harukakido/NASAProject.FPGACompatibleMIPICameraInterfaceAdapterBoard/Images of Final Adapter Board/Final Adapter Board 2D JPG.JPG

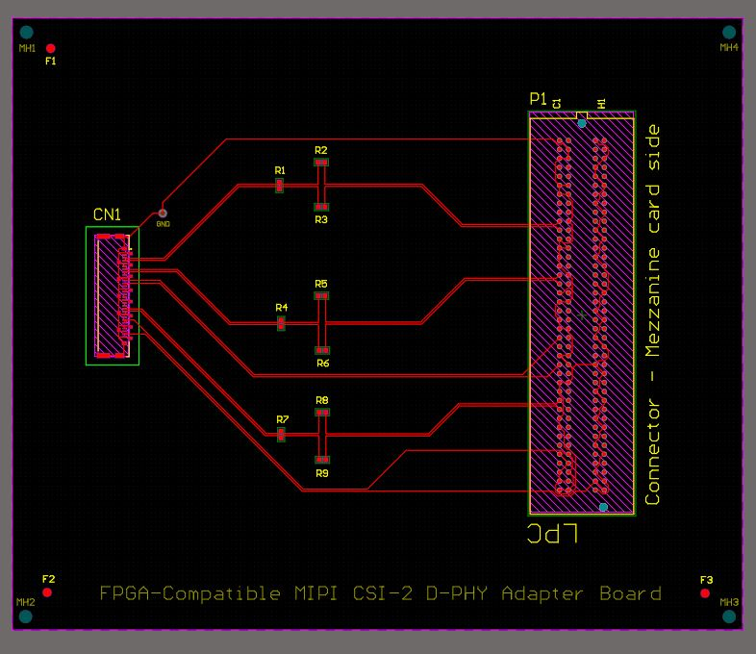
Images of Final Adapter Board/Final Adapter Board 2D JPG.JPG
