harukakido/NASAProject.FPGACompatibleMIPICameraInterfaceAdapterBoard/Images of Final Adapter Board/Final Adapter Board 3D Top JPG.JPG

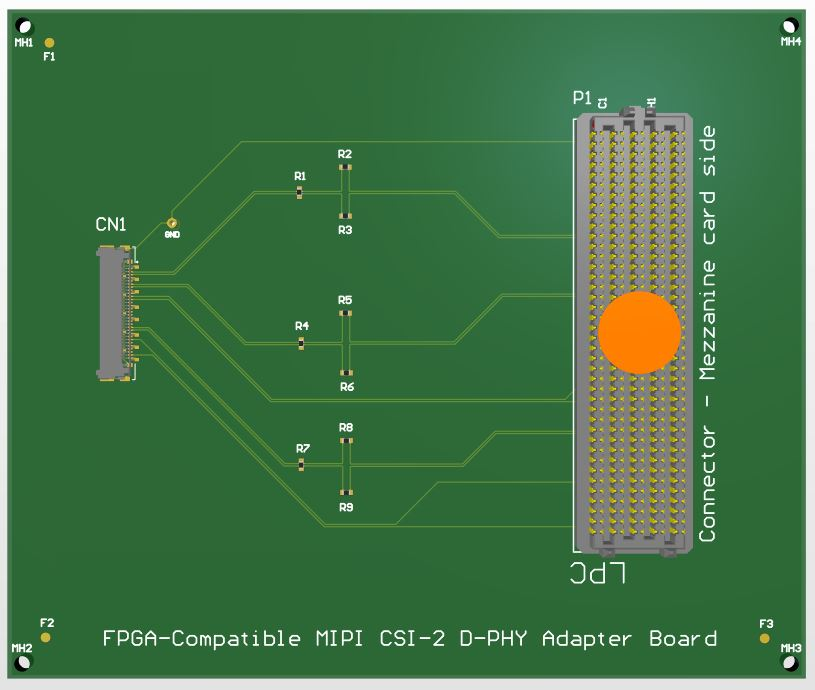
Images of Final Adapter Board/Final Adapter Board 3D Top JPG.JPG
