harukakido/NASAProject.FPGACompatibleMIPICameraInterfaceAdapterBoard/Altium PCB Output List.txt

Altium PCB Output List:

1. Fabrication Outputs: Gerbers, NC Drill Files

2. Export Outputs:
3D STEP File (View after upload to online AutoDesk Viewer)

3. Assembly Drawing (PCB Print as PDF)

4. Assembly Outputs:
Pick and Place

5. Documentation Outputs:
PDF Schematic, 3D PDF, Draftsman

6. Report Outputs:
Bill of Materials (BOM)
	
*Printing at Home: Composite Drawing (for Layers)
