harukakido/NASAProject.FPGACompatibleMIPICameraInterfaceAdapterBoard/Altium PCB Output List.docx

Altium PCB Output List:

1. Fabrication Outputs:
- Gerbers (test file output via ViewMate in PentaLogix)
- NC Drill Files
- ODB

2. Export Outputs:

- 3D STEP File (View after upload to online AutoDesk Viewer)
3. Assembly Drawing (PCB Print as PDF)
4. Assembly Outputs: Pick and Place

5. Documentation Outputs:

- PDF Schematic, 3D PDF, Draftsman (Top Side)
- *Printing at Home: Composite Drawing (Layers)
5. Report Outputs:
  - Bill of Materials (BOM)
