harukakido/NASAProject.FPGACompatibleMIPICameraInterfaceAdapterBoard/Deliverables/Final Presentation. Embedded Processing.pdf

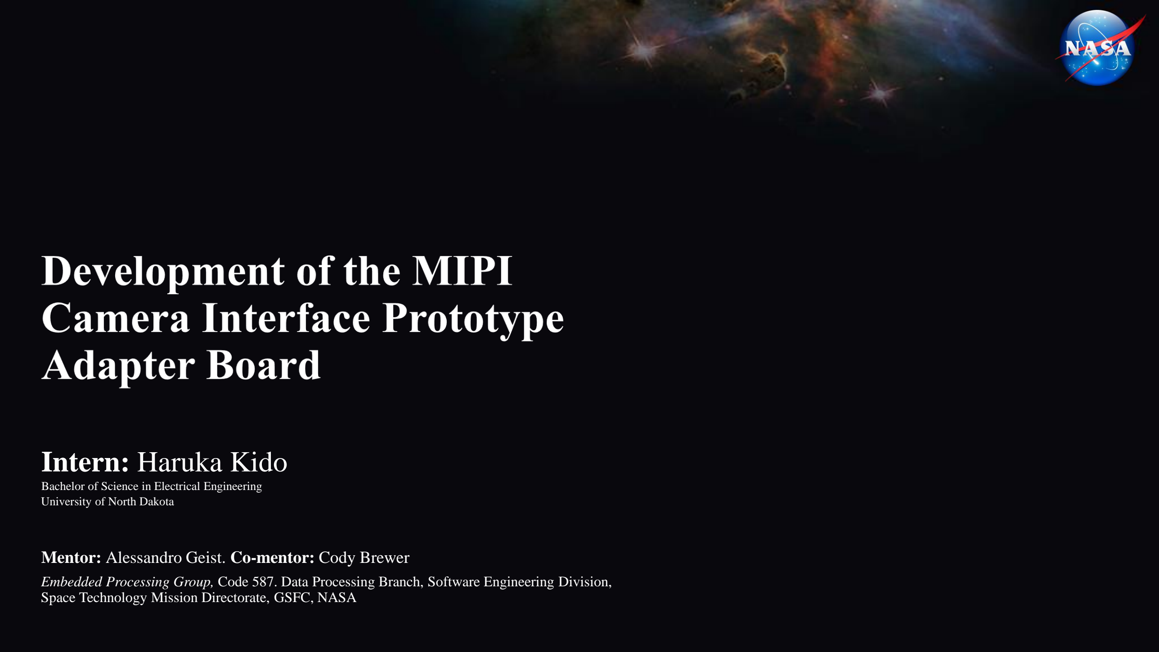
[picture p3: page 1]

# Intern: Haruka Kido

Embedded Processing Group, Code 587. Data Processing Branch, Software Engineering Division,

### Space Technology Mission Directorate, GSFC, NASA

## Mentor: Alessandro Geist. Co-mentor: Cody Brewer

Bachelor of Science in Electrical Engineering University of North Dakota

This project is the development of the prototype FPGA-Compatible MIPI CSI-2 (Camera Serial Interface) D-PHY adapter board. The FPGA used on the SpaceCube processor card does not have I/O that natively supports the D-PHY standard, and thus requires additional external components to adapt the interface to the FPGAs I/O. The goal of this project is to develop a prototype board with this external circuitry. The project tasks include 1) preliminary research and analysis of the adapter circuit requirements involving waveform comparisons, 2) signal processing chain tests for voltage measurements, 3) calculations from I/O channel system simulations in TI-TINA, 4) components’ values and circuit configuration verifications, 5) protoboard schematic entry, 6) both PCB footprint builds and PCB layout in Altium Designer, and lastly, 7) PCB manufacturing. This adapter board is useful in data conversion and transmission from the MIPI camera module to the FPGA, a D-PHY circuit arrangement used in NASA’s SpaceCube Mini’s VADIR (Versatile Analog/Digital Interface) between the MIPI Camera module and the Backplane Connector.

## FPGA-Compatible MIPI CSI-2 D-PHY Adapter Board Development Methodology

## Protoboard Fabrication

## Protoboard PCB Layout

•PCB footprint builds
> Component
placements
•Determination of PCB
Stack-Up and Rules
(length-matching for
differential pairs,
controlled impedance,
copper specifications:
trace measurements)
> Trace Routing

## Protoboard Schematic Entry (Altium)

•Parts selection and
symbol builds
•Schematic Entry: Add
and wire components,
adjust I/O pin
arrangements

## Conversion Simulation of MIPI (TI TINA)

•Research MIPI D-PHY and LVDS:
Expected Voltage
Levels and Rates
•Transmitter and
Receiver Circuit
Simulations
•Waveform Outputs
from signal
processing chain
tests for voltage
measurements
•Calculations from
I/O channel system
simulations
•Components’ values
and circuit
configuration
verifications

•Final gerber file
output, assembly
drawings, BOM
•Quotes
•Place Order
NASA Embedded Processing Internship, Summer 2021 | 2

# Engineering Contextualization: SpaceCube Configurable Slices

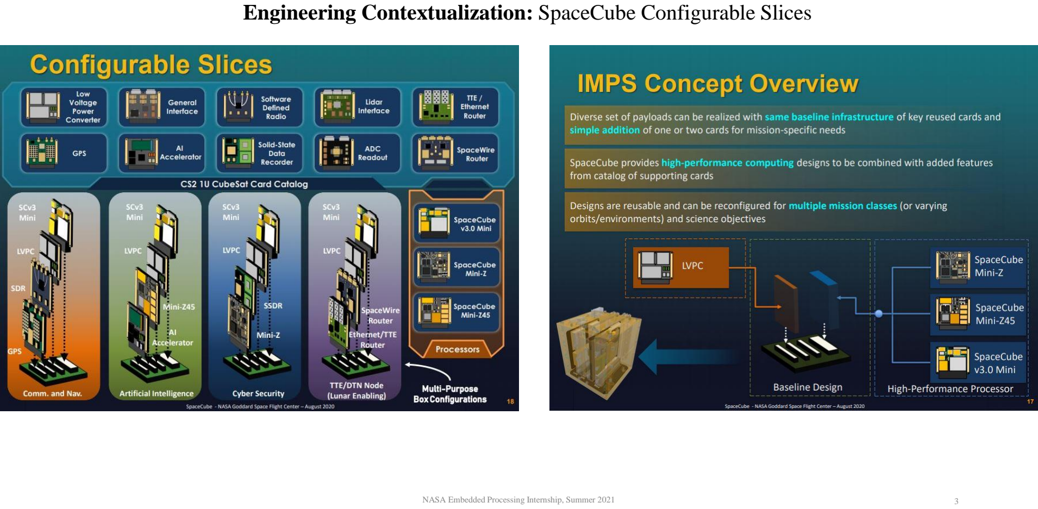
[picture p4: page 3]

# Engineering Contextualization: MIPI Adapter in SpaceCube’s Versatile Analog-Digital Interface (VADIR) Card

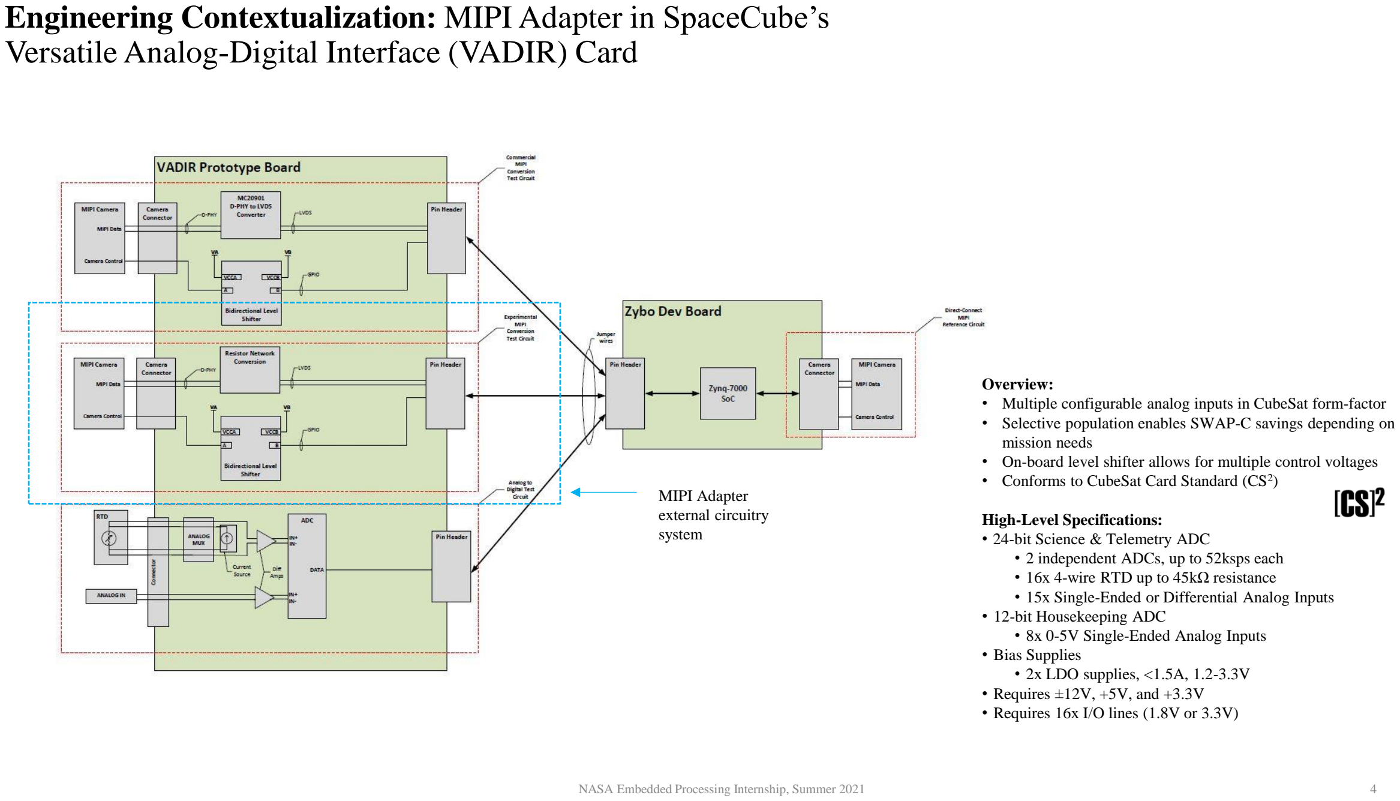
[picture p5: page 4]

MIPI Adapter
external circuitry
system

Overview:
- Multiple configurable analog inputs in CubeSat form-factor
- Selective population enables SWAP-C savings depending on mission needs
- On-board level shifter allows for multiple control voltages
- Conforms to CubeSat Card Standard (CS²
)

High-Level Specifications:
- 24-bit Science & Telemetry ADC
- 2 independent ADCs, up to 52ksps each
- 16x 4-wire RTD up to 45kΩ resistance
- 15x Single-Ended or Differential Analog Inputs
- 12-bit Housekeeping ADC
- 8x 0-5V Single-Ended Analog Inputs
- Bias Supplies
- 2x LDO supplies, <1.5A, 1.2-3.3V
- Requires ±12V, +5V, and +3.3V
- Requires 16x I/O lines (1.8V or 3.3V)

## Preliminary Research and Analysis: Schematics of Resistor Networks

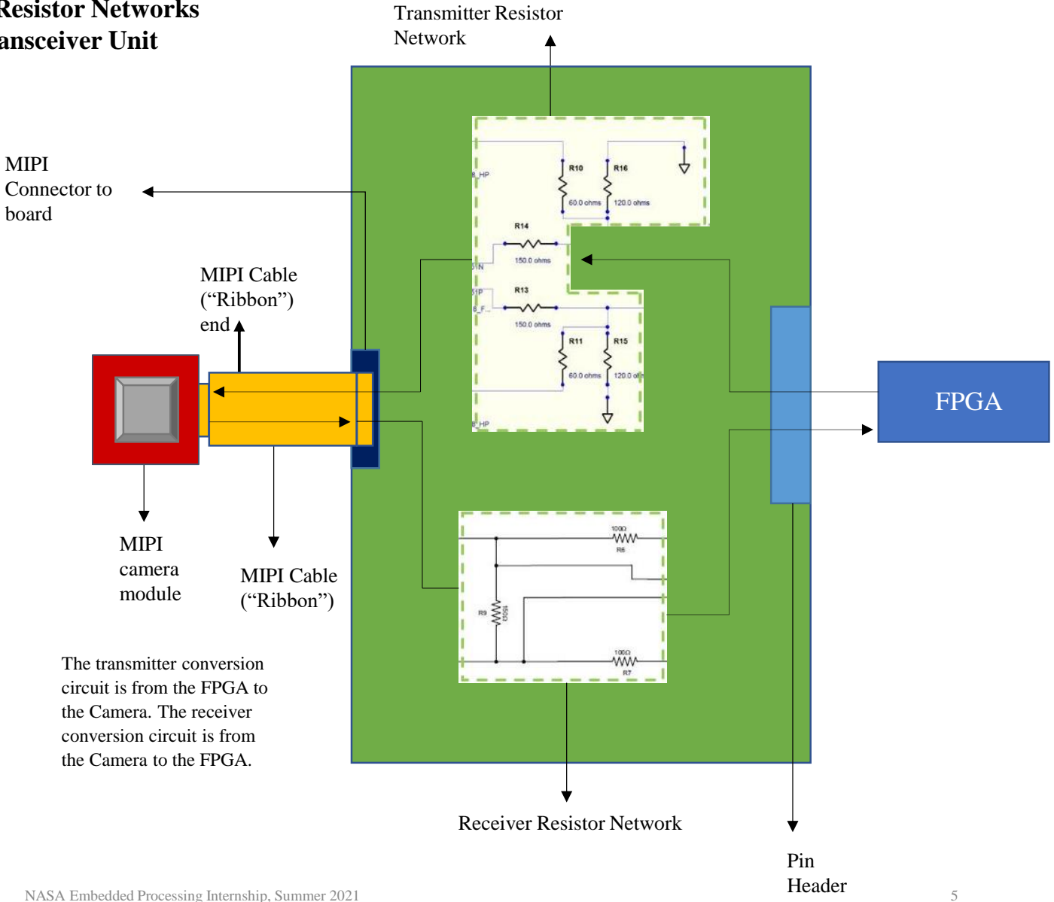
[picture p6: figure]
Pin Header; MIPI Cable (“Ribbon”); Transmitter Resistor Network; MIPI Connector to board; MIPI Cable (“Ribbon”) end; MIPI camera module; FPGA; Receiver Resistor Network; The transmitter conversion circuit is from the FPGA to the Camera. The receiver conversion circuit is from the Camera to the FPGA.

## and System Integration Mapping of MIPI CSI-2 Transceiver Unit

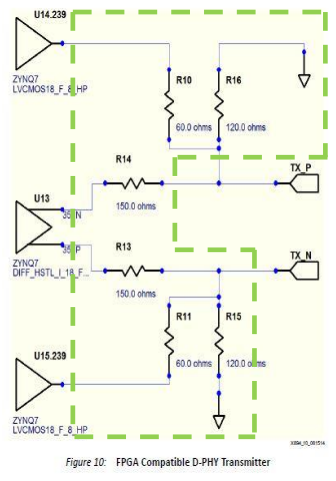
[picture p7: figure]
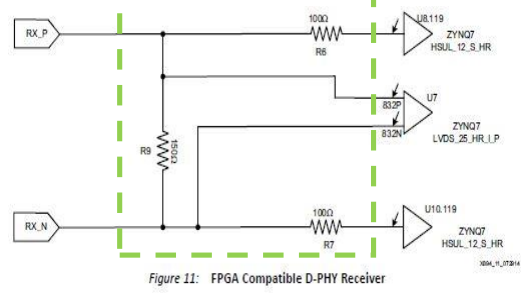
[picture p8: figure]

# TI TINA Simulations for Receiver Network:

## Signal-Processing Chain Tests, Waveform Analyses, Voltage Measurements and Calculations

# U7 (LVDS_25) + U8/10 (HSUL)

# FPGA-Compatible D-PHY Receiver Baseline Circuit Simulations and Waveform Analyses:

- The FPGA inputs do not need to be simulated in attempting to verify that given a MIPI D-PHY input, the resistor network will output a signal that is compatible with the LVDS (for HS) or HSUL (for LP) I/O standard.
- The baseline simulation will be an attempt to see what is present at the resistor network output.
- U8 and U10 are assumed to be high impedance inputs (effectively open) and U7 is assumed to have an internal 100Ω differential termination.
- The HS (LVDS_25) and LP (HSUL_12) cases are analyzed separately.

# U7; HS, (LVDS_25) Baseline Circuit Simulation

## U7; HS, (LVDS_25_HR_I_P (Low-Voltage

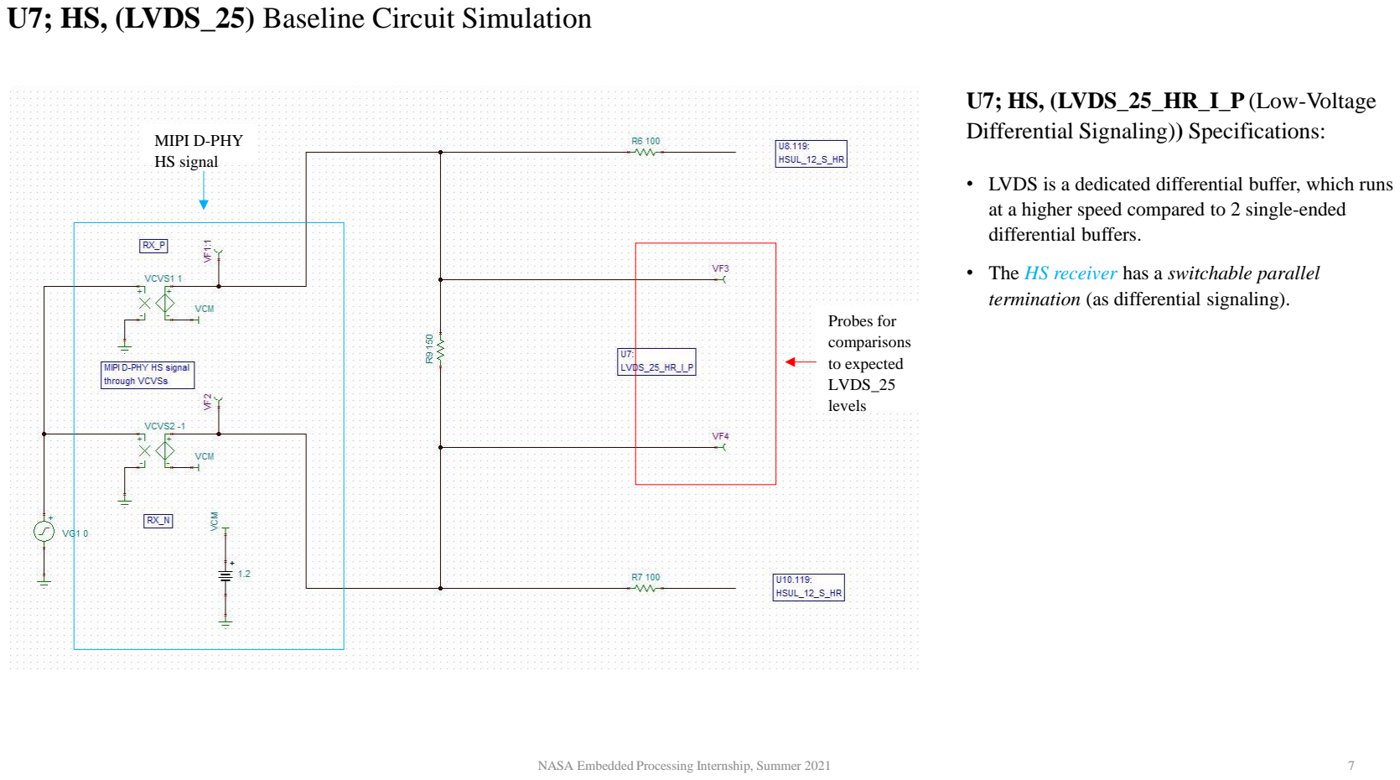
[picture p9: page 7]

Probes for
comparisons
to expected
LVDS_25
levels

MIPI D-PHY
HS signal

## Differential Signaling)) Specifications:

### - LVDS is a dedicated differential buffer, which runs at a higher speed compared to 2 single-ended

differential buffers.

### - The HS receiver has a switchable parallel

termination (as differential signaling).

# U7; HS, (LVDS_25) Waveform Analysis

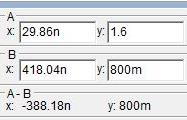
[picture p10: figure]

### Xilinx Specifications (Expected Values):

VCCO = 2.5V
2.375V < VCCO (supply voltage) < 2.625V

RT = 100Ω
VOH, MAX = 1.675V
VOL, MIN = 0.700V
1V < VOCM (output common-mode voltage) < 1.425V .3 V < VICM < 1.5 V

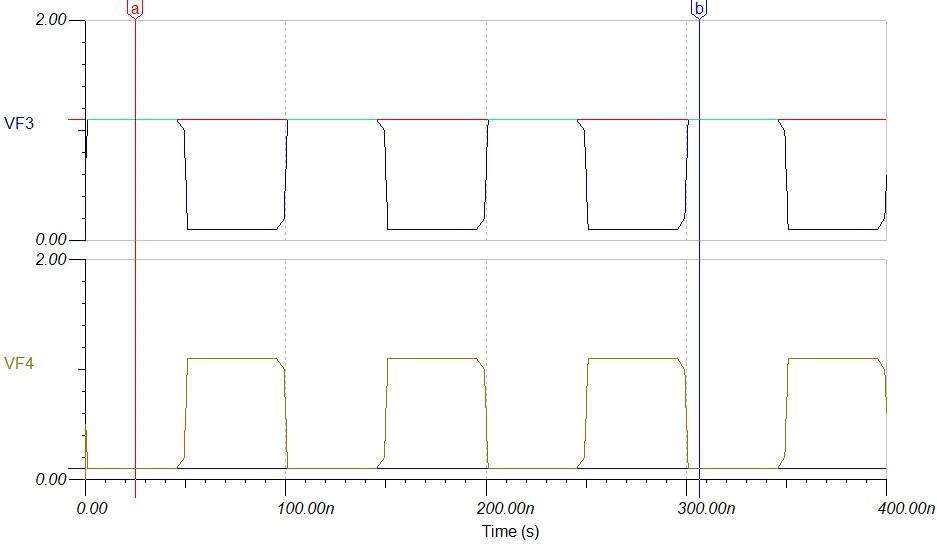
[picture p11: figure]

Waveform Values (VF3 and VF4):

VG1 = 0V
Amplitude: 0.4V
VCM = 1.2V
VOL = 0.8V
VOH = 1.6V

# U8/U10; LP, (HSUL_12) Baseline Circuit Simulation

## U8/U10; LP, (HSUL_12_S_HR (High

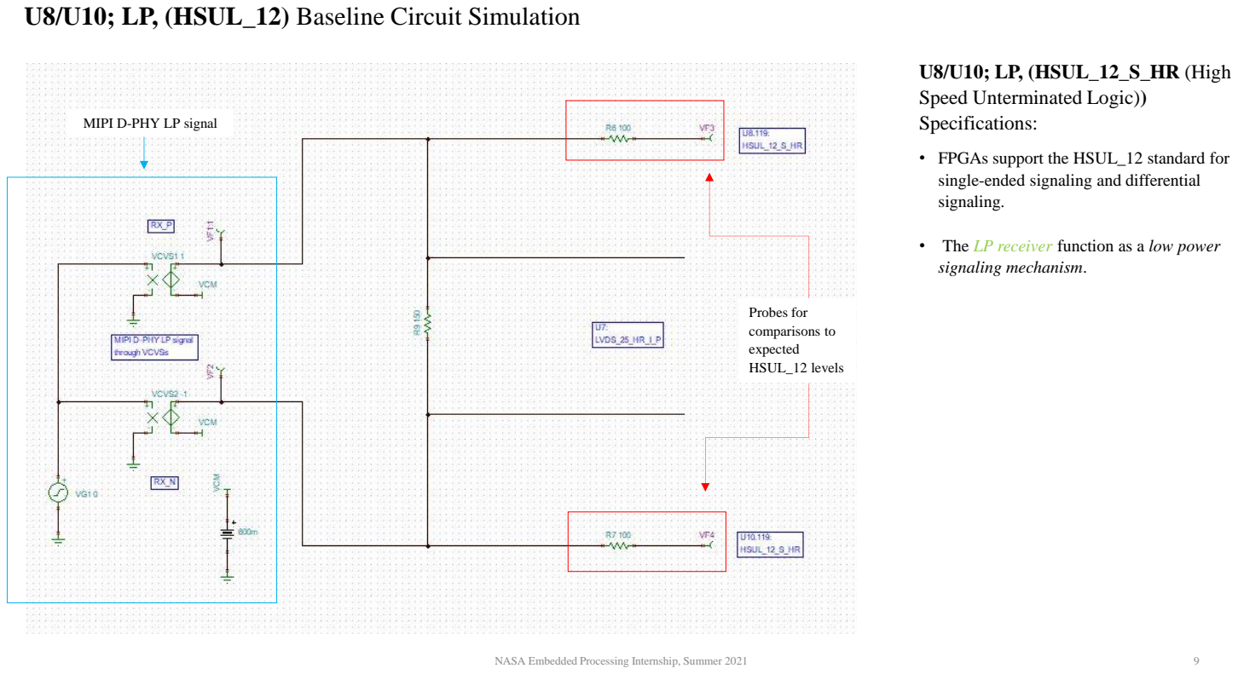
[picture p12: page 9]

MIPI D-PHY LP signal

Probes for
comparisons to
expected
HSUL_12 levels

## Speed Unterminated Logic)) Specifications:

### - FPGAs support the HSUL_12 standard for single-ended signaling and differential

signaling.

### - The LP receiver function as a low power

signaling mechanism.

# U8/U10; LP, (HSUL_12) Waveform Analysis

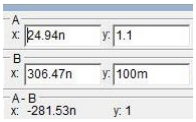
[picture p13: figure]

### Xilinx Specifications (Expected Values):

VREF (Input) = 0.6V
VCCO (Output) = 1.2 V
VCCO (Input) = Any

-0.300V < VIL < VREF – 0.130V
VREF + 0.130V < VIH < VCCO + 0.300V

VOL, MAX = 20% (VCCO)

VOH, MIN = 80% (VCCO)

Calculations:

VOL, MAX = 20% (VCCO)
VOL, MAX = 20% (1.2V)
VOL, MAX = .24V

VOH, MIN = 80% (VCCO)
VOH, MIN = 80% (1.2V)
VOH, MIN = .96V

Waveform Values (VF3 and VF4):

VG1 = 0V
Amplitude = 0.5V
VCM = 0.6V
VOL = 0.1V
VOH = 1.1V

# Circuit Schematic (.SchDoc):

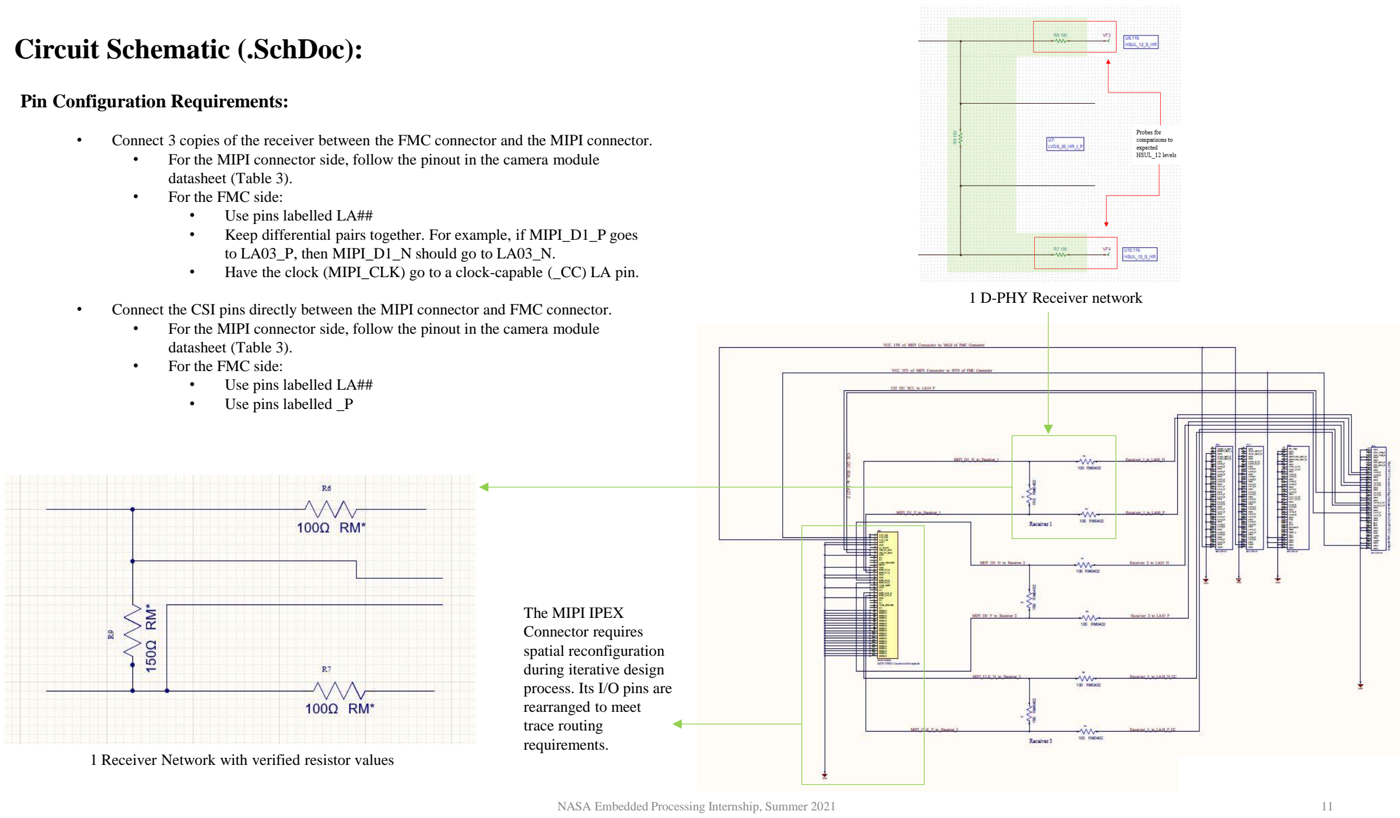
[picture p14: page 11]

1 D-PHY Receiver network

The MIPI IPEX
Connector requires
spatial reconfiguration
during iterative design
process. Its I/O pins are
rearranged to meet
trace routing
requirements.
1 Receiver Network with verified resistor values

Pin Configuration Requirements:

- Connect 3 copies of the receiver between the FMC connector and the MIPI connector.
- For the MIPI connector side, follow the pinout in the camera module datasheet (Table 3).
- For the FMC side:
- Use pins labelled LA##
- Keep differential pairs together. For example, if MIPI_D1_P goes to LA03_P, then MIPI_D1_N should go to LA03_N.
- Have the clock (MIPI_CLK) go to a clock-capable (_CC) LA pin.
- Connect the CSI pins directly between the MIPI connector and FMC connector.
- For the MIPI connector side, follow the pinout in the camera module datasheet (Table 3).
- For the FMC side:
- Use pins labelled LA##
- Use pins labelled _P

# Final Circuit Schematic in Altium

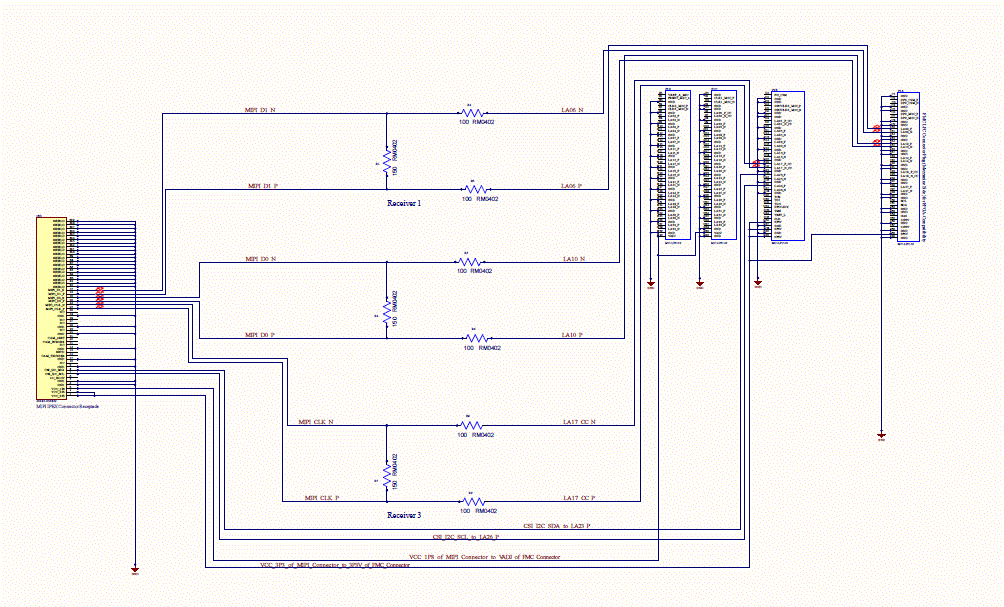
[picture p15: figure]

FPGA-Compatible MIPI CSI-2 D-PHY Adapter Board Circuit Schematic

# Using the TI-TINA Simulation’s Receiver Voltage Probe Results for verification of the 150 Ω resistor package type

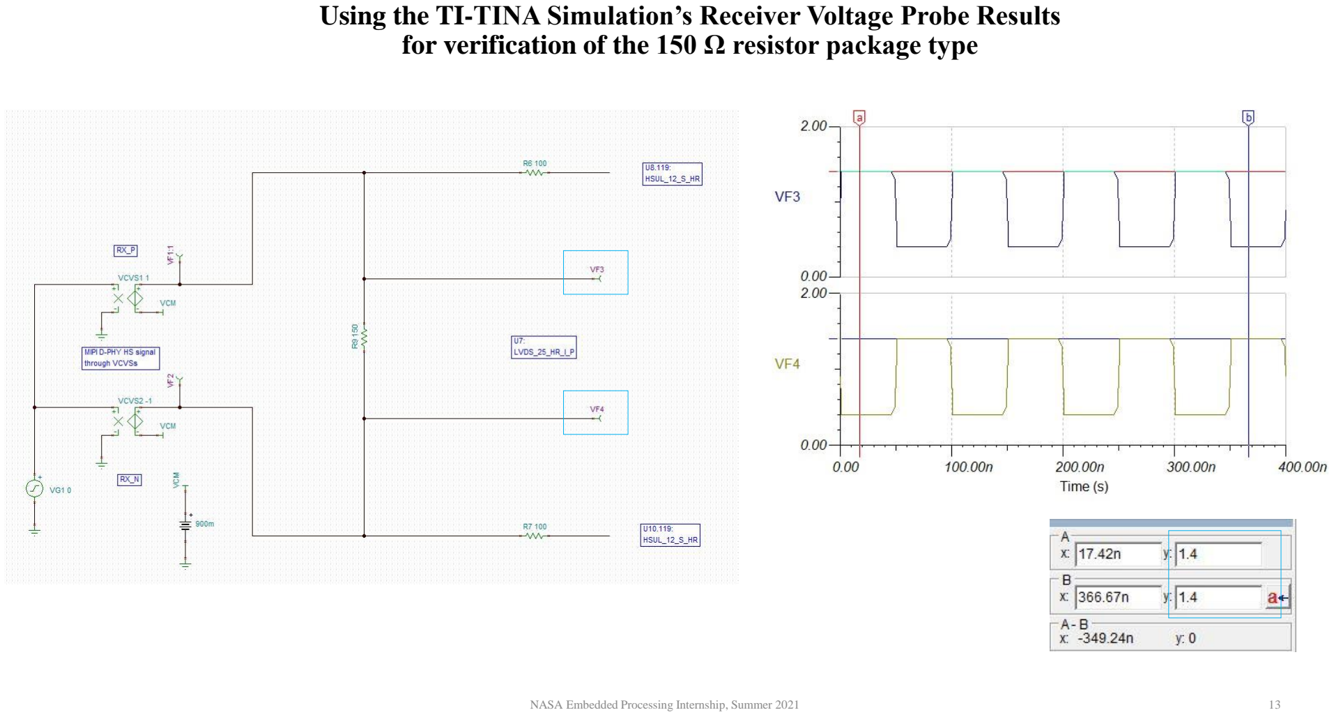
[picture p16: page 13]

# Calculations of current and allowable dissipated power for verification of the 150 Ω resistor package type

## (Using NEP: Power Dissipation Ratings for Resistors (after 2007)):

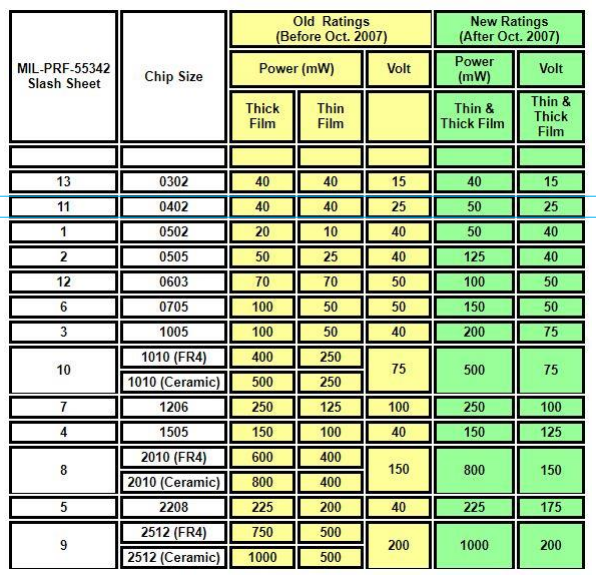
[picture p17: figure]

On calculating for the appropriate power rating for the 150Ω resistor:

From the circuit simulation, V = 1.4 V.

V = IR

### 1.4 V = (I)(150 Ω)

1.4 V/(150 Ω) = 0.00933 A = I

Pdissipated = I²R

Pdissipated = (0.0093333333 A)²
(150 Ω)

Pdissipated = (0.00008711111111)(150) = 0.0130666667 W

or simply from P = V^2/R = (1.4)^2/(150) = 1.96/150 = 0.0130666667 W

If the calculated dissipated power does not exceed the power rating of the resistor for a particular package type, then there is no resistor degradation. Since 0.0130666667 W does not exceed the 0402 package type power rating of 50 mW (or 0.05 W), the 0402 package type is sufficient to use.

The power rating specifies the maximum steady state power the package allows to dissipate under given conditions (at the rated ambient temperature).

The voltage rating is typically for the resistor series and specifies the maximum peak voltage that can be continuously applied to a resistor at a rated ambient temperature without resistor degradation.

# MIPI I-PEX Connector Receptacle

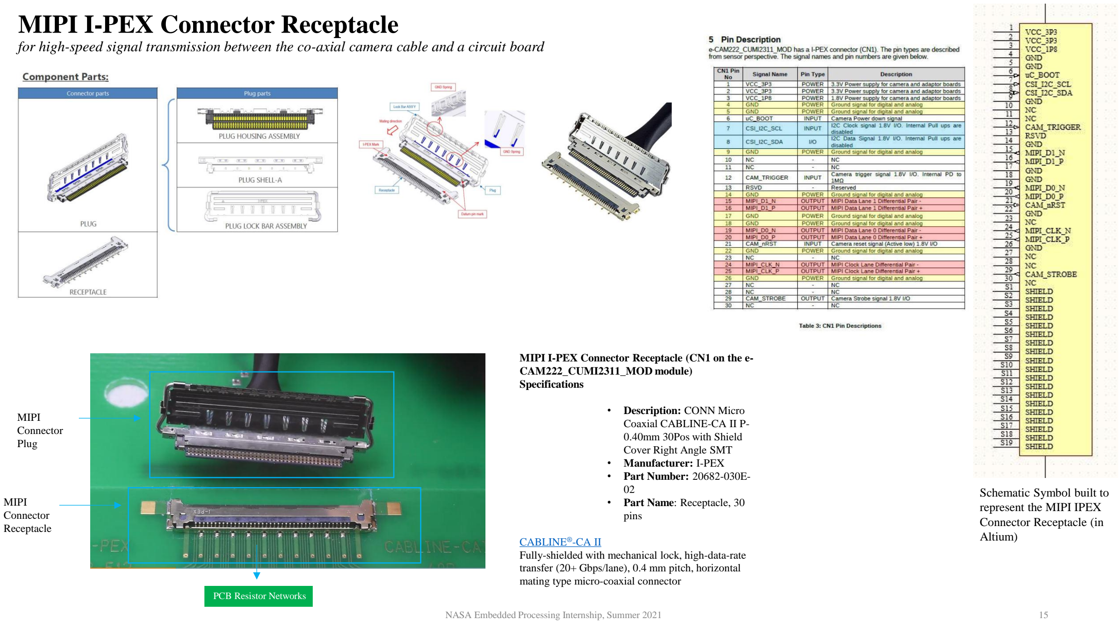
[picture p18: page 15]

MIPI I-PEX Connector Receptacle (CN1 on the e-CAM222_CUMI2311_MOD module) Specifications

- Description: CONN Micro
Coaxial CABLINE-CA II P-0.40mm 30Pos with Shield
Cover Right Angle SMT
- Manufacturer: I-PEX
- Part Number: 20682-030E-02
- Part Name: Receptacle, 30 pins

CABLINE®-CA II (https://www.i-pex.com/product/cabline-ca-II)
Fully-shielded with mechanical lock, high-data-rate transfer (20+ Gbps/lane), 0.4 mm pitch, horizontal mating type micro-coaxial connector

MIPI
Connector
Plug

MIPI
Connector
Receptacle

PCB Resistor Networks

### for high-speed signal transmission between the co-axial camera cable and a circuit board

Schematic Symbol built to
represent the MIPI IPEX
Connector Receptacle (in
Altium)

# Building the MIPI I-PEX Connector Receptacle

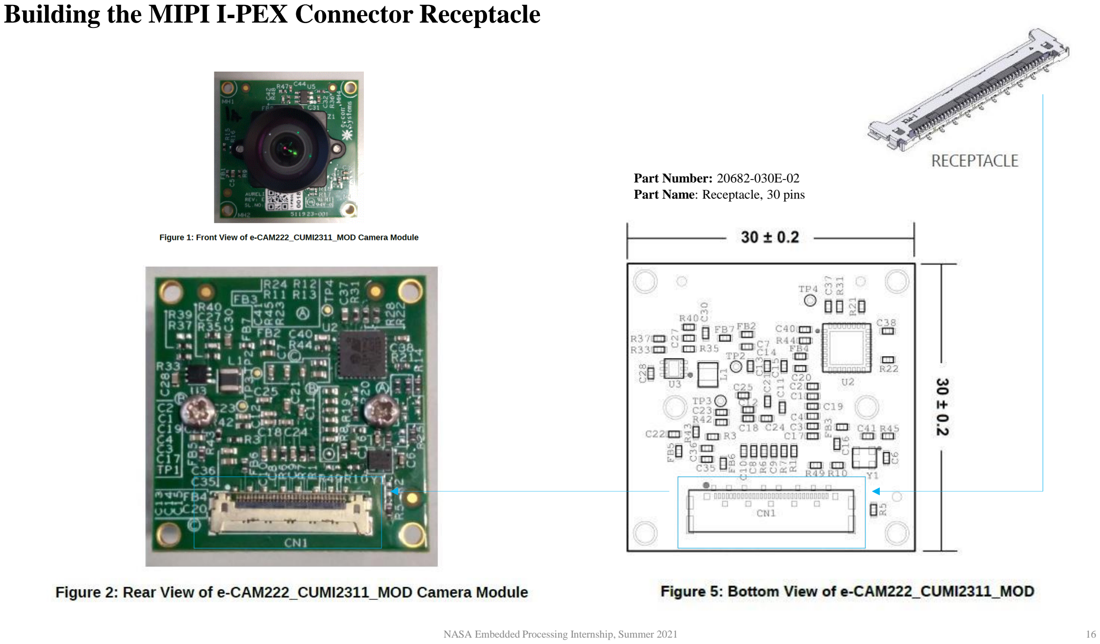
[picture p19: page 16]

Part Number: 20682-030E-02 Part Name: Receptacle, 30 pins

## Top and Mechanical Layers

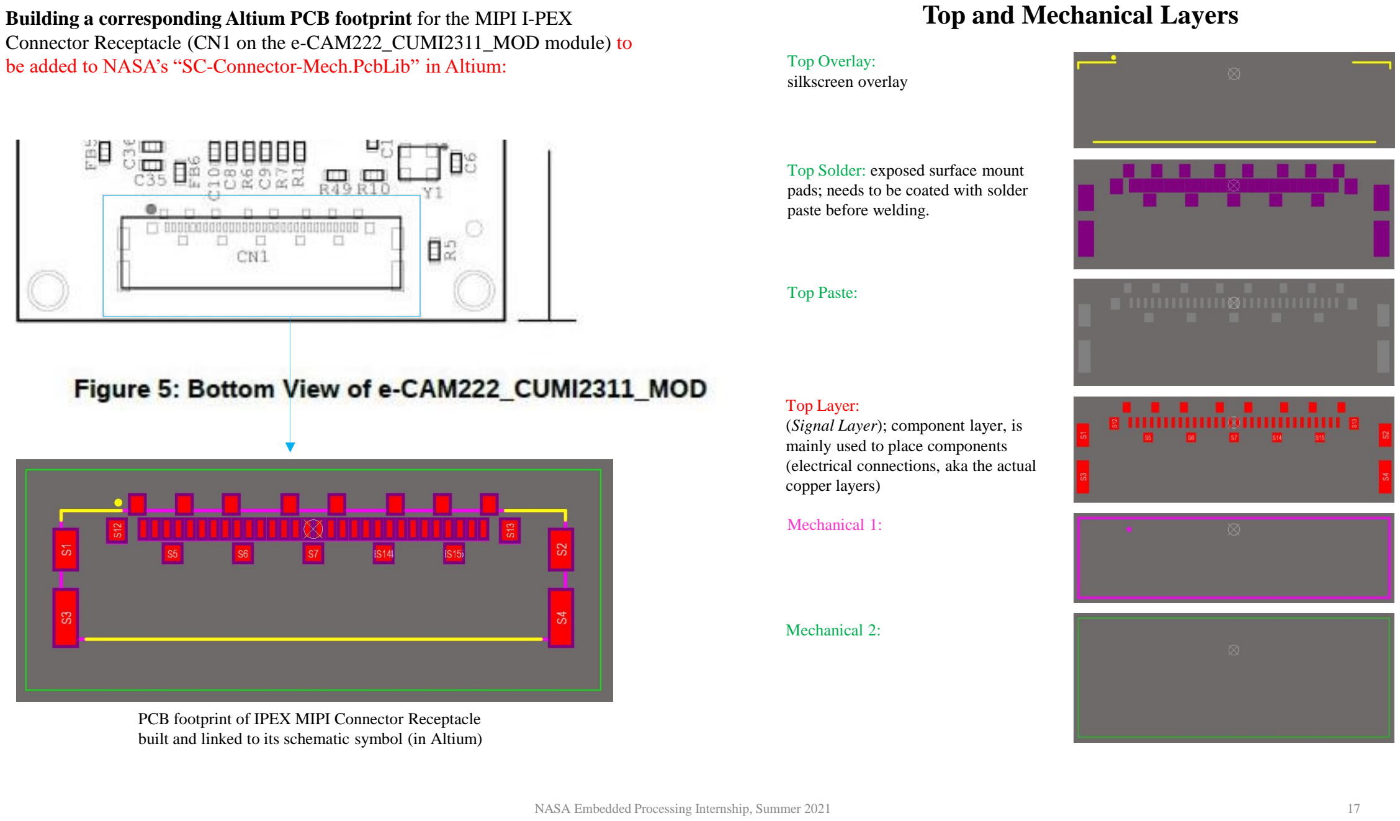
[picture p20: page 17]

Top Layer:
(Signal Layer); component layer, is mainly used to place components (electrical connections, aka the actual copper layers)

Top Overlay:
silkscreen overlay

Top Solder: exposed surface mount pads; needs to be coated with solder paste before welding.

Top Paste:

Mechanical 1:

Mechanical 2:

Building a corresponding Altium PCB footprint for the MIPI I-PEX

### Connector Receptacle (CN1 on the e-CAM222_CUMI2311_MOD module) to be added to NASA’s “SC-Connector-Mech.PcbLib” in Altium:

PCB footprint of IPEX MIPI Connector Receptacle built and linked to its schematic symbol (in Altium)

Linking the schematic symbol to the PCB footprint and 3D model between

### NASA’s “SC-Connector-Mech.SchLib” and “SC-Connector-Mech.PcbLib” in Altium:

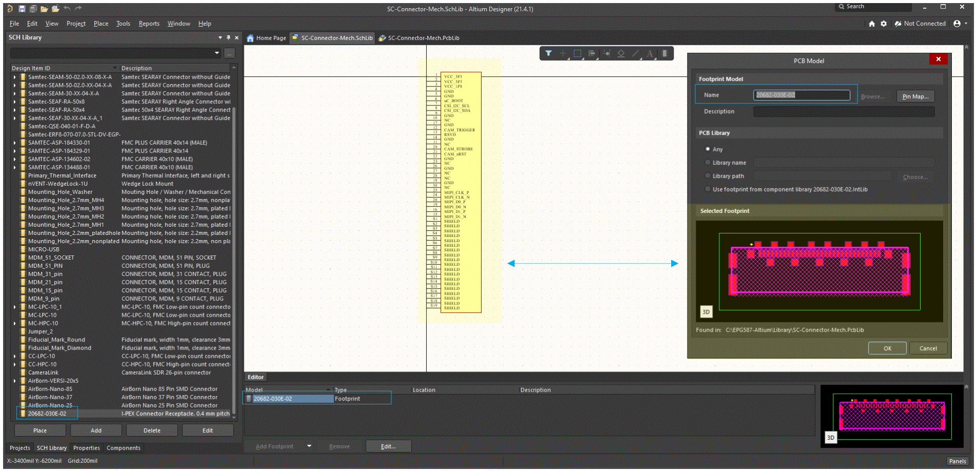
[picture p21: figure]

# Building the FMC Connector Plug

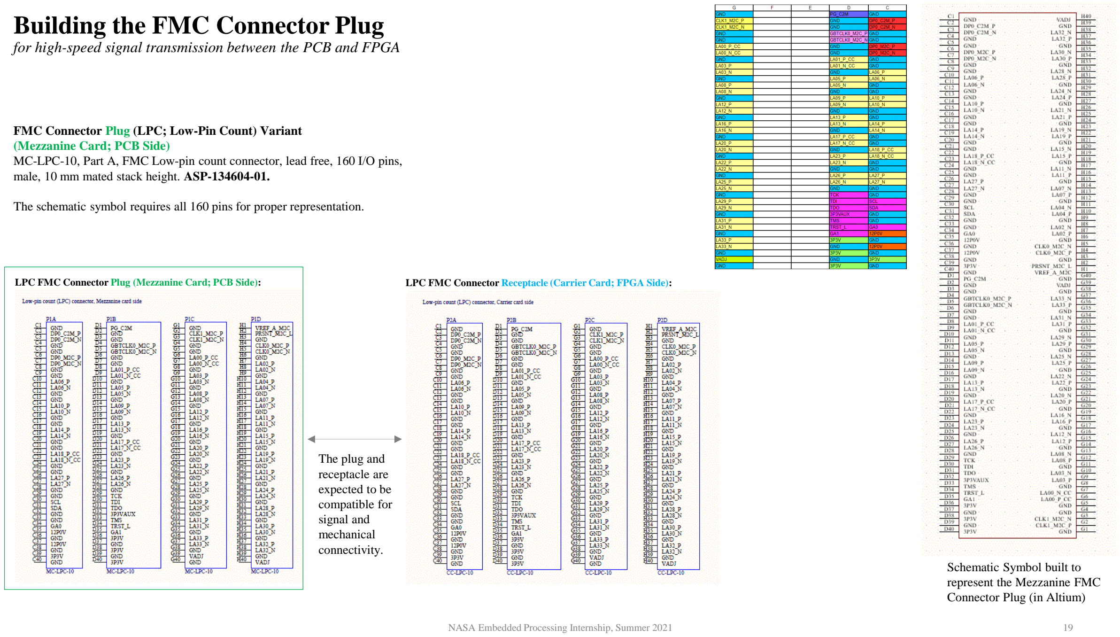
[picture p22: page 19]

FMC Connector Plug (LPC; Low-Pin Count) Variant
(Mezzanine Card; PCB Side)
MC-LPC-10, Part A, FMC Low-pin count connector, lead free, 160 I/O pins, male, 10 mm mated stack height. ASP-134604-01.

The schematic symbol requires all 160 pins for proper representation.

### for high-speed signal transmission between the PCB and FPGA

LPC FMC Connector Plug (Mezzanine Card; PCB Side): | LPC FMC Connector Receptacle (Carrier Card; FPGA Side):

The plug and
receptacle are
expected to be
compatible for
signal and
mechanical
connectivity.
Schematic Symbol built to
represent the Mezzanine FMC Connector Plug (in Altium)

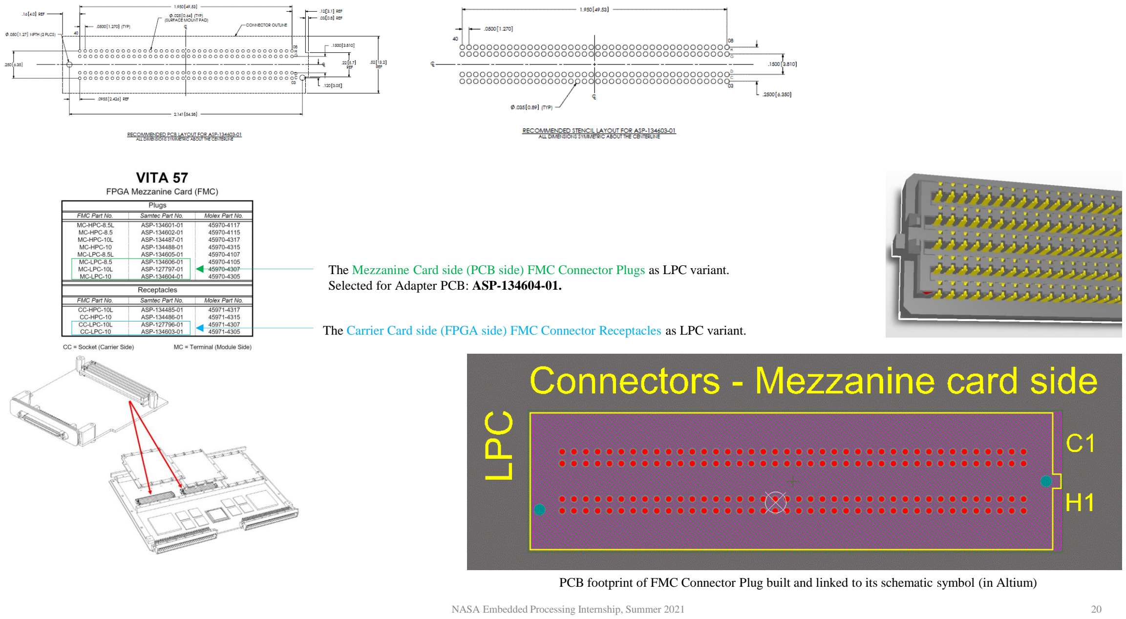
[picture p23: page 20]

The Mezzanine Card side (PCB side) FMC Connector Plugs as LPC variant. Selected for Adapter PCB: ASP-134604-01.

The Carrier Card side (FPGA side) FMC Connector Receptacles as LPC variant.

PCB footprint of FMC Connector Plug built and linked to its schematic symbol (in Altium)

## Trace Routing Optimization from Default PCB Top Signal Layer

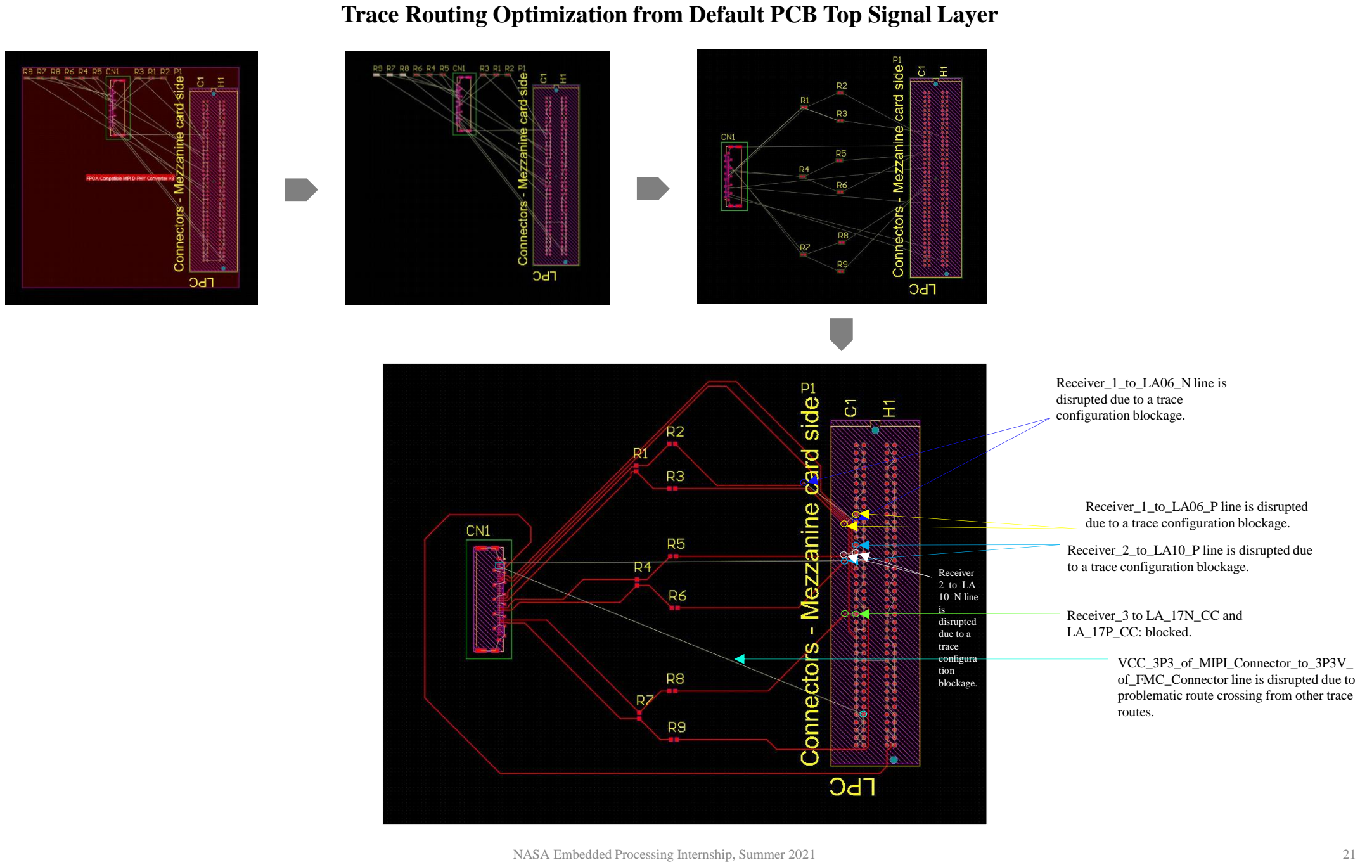
[picture p24: page 21]

VCC_3P3_of_MIPI_Connector_to_3P3V_ of_FMC_Connector line is disrupted due to problematic route crossing from other trace routes.

Receiver_1_to_LA06_N line is disrupted due to a trace
configuration blockage.

Receiver_1_to_LA06_P line is disrupted due to a trace configuration blockage.

Receiver_2_to_LA10_P line is disrupted due to a trace configuration blockage. Receiver_

2_to_LA
10_N line
is
disrupted
due to a
trace
configura
tion
blockage.

Receiver_3 to LA_17N_CC and LA_17P_CC: blocked.

# Optimization of Trace Routes and Via Placement

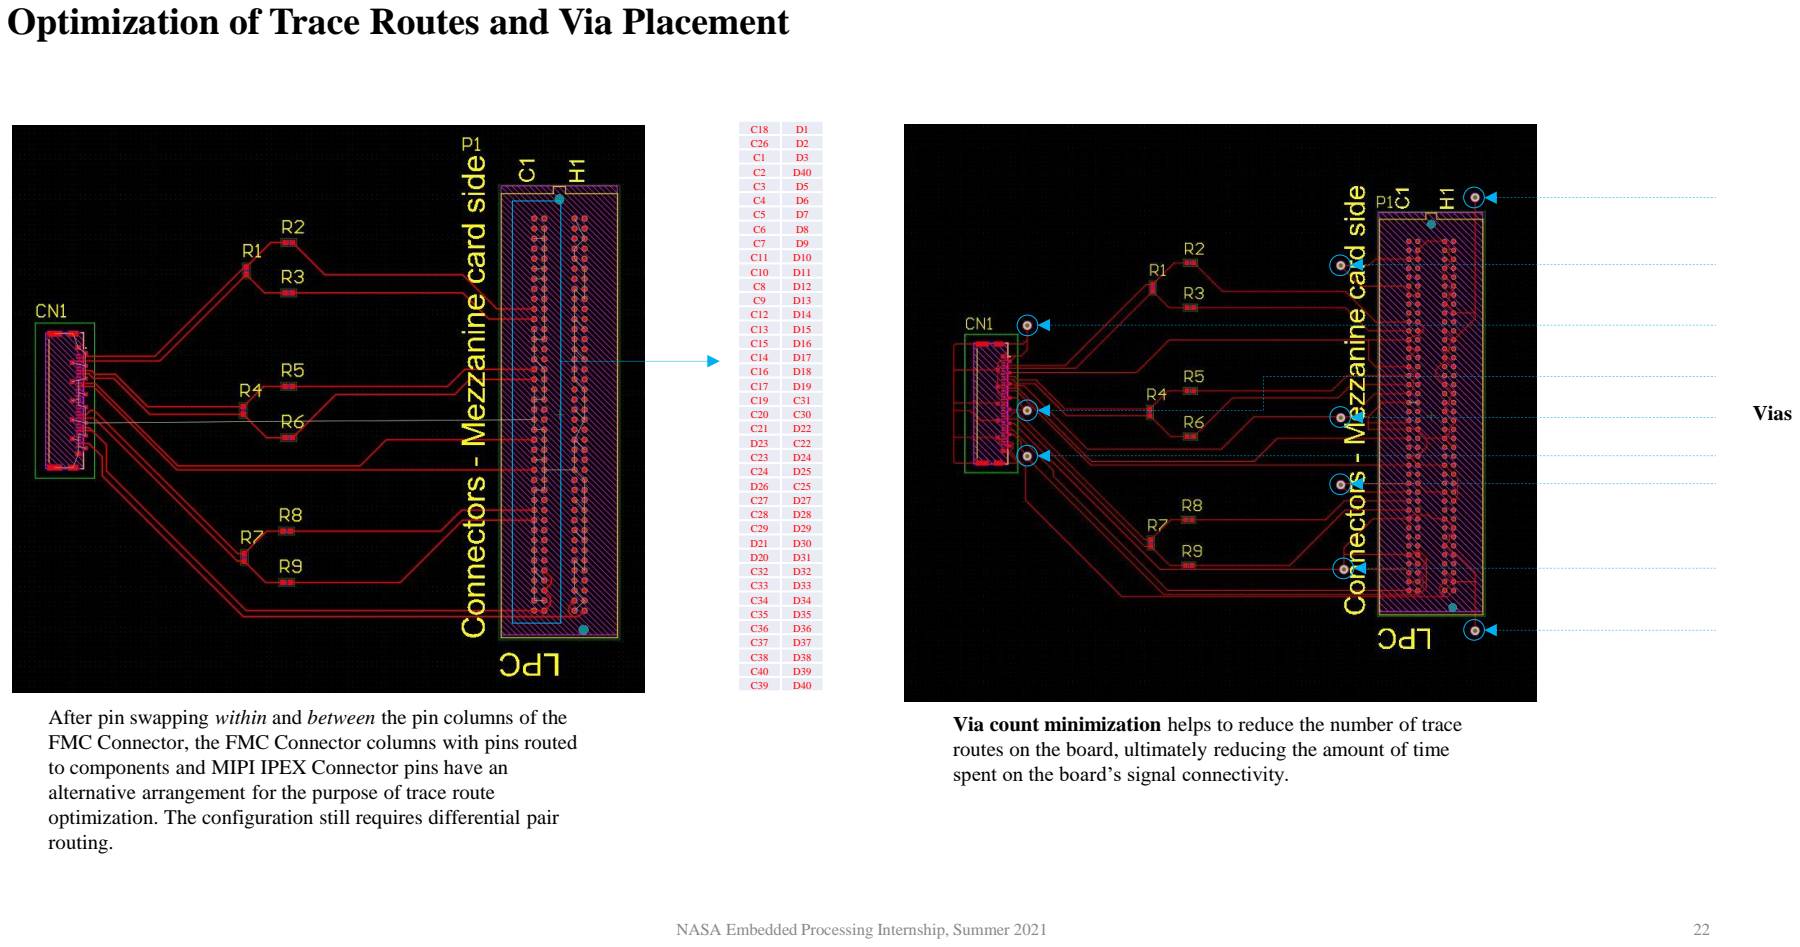
[picture p25: page 22]

C18 | D1
C26 | D2
C1 | D3
C2 | D40
C3 | D5
C4 | D6
C5 | D7
C6 | D8
C7 | D9
C11 | D10
C10 | D11
C8 | D12
C9 | D13
C12 | D14
C13 | D15
C15 | D16
C14 | D17
C16 | D18
C17 | D19
C19 | C31
C20 | C30
C21 | D22
D23 | C22
C23 | D24
C24 | D25
D26 | C25
C27 | D27
C28 | D28
C29 | D29
D21 | D30
D20 | D31
C32 | D32
C33 | D33
C34 | D34
C35 | D35
C36 | D36
C37 | D37
C38 | D38
C40 | D39
C39 | D40

After pin swapping within and between the pin columns of the
FMC Connector, the FMC Connector columns with pins routed
to components and MIPI IPEX Connector pins have an
alternative arrangement for the purpose of trace route
optimization. The configuration still requires differential pair
routing.

Via count minimization helps to reduce the number of trace
routes on the board, ultimately reducing the amount of time
spent on the board’s signal connectivity.

## Final PCB Configuration: FPGA-Compatible MIPI CSI-2 (Camera Serial

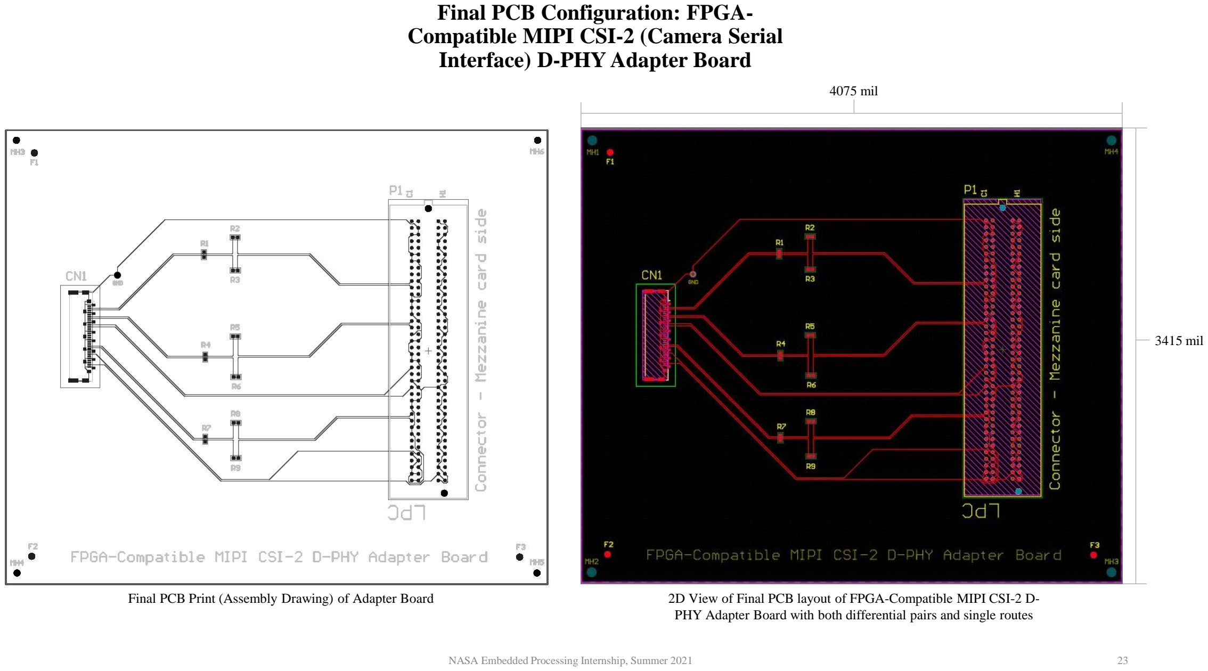
[picture p26: page 23]

## Interface) D-PHY Adapter Board

2D View of Final PCB layout of FPGA-Compatible MIPI CSI-2 D-PHY Adapter Board with both differential pairs and single routes

4075 mil

3415 mil

Final PCB Print (Assembly Drawing) of Adapter Board

## Final PCB Configuration in Altium’s 3D View: FPGA-Compatible MIPI CSI-2 (Camera Serial Interface) D-PHY Adapter Board

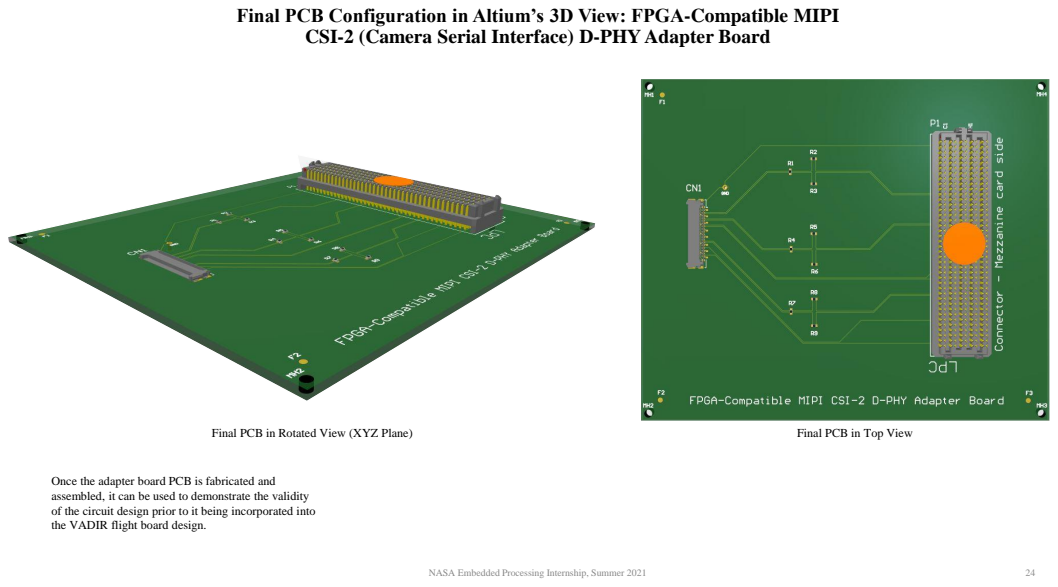
[picture p27: page 24]
Final PCB in Rotated View (XYZ Plane); Final PCB in Top View

Once the adapter board PCB is fabricated and
assembled, it can be used to demonstrate the validity
of the circuit design prior to it being incorporated into
the VADIR flight board design.

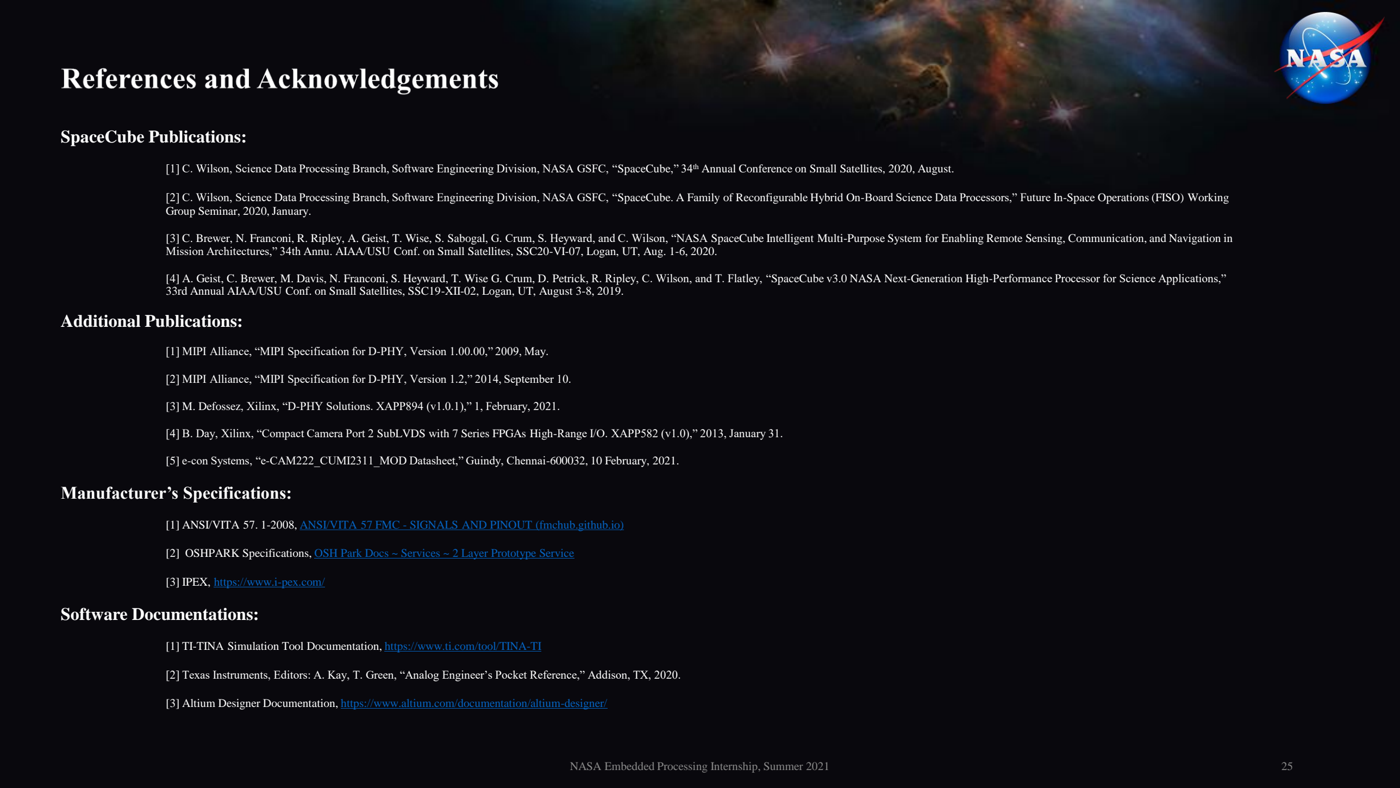
[picture p28: page 25]

SpaceCube Publications:

[1] C. Wilson, Science Data Processing Branch, Software Engineering Division, NASA GSFC, “SpaceCube,” 34th Annual Conference on Small Satellites, 2020, August.
[2] C. Wilson, Science Data Processing Branch, Software Engineering Division, NASA GSFC, “SpaceCube. A Family of Reconfigurable Hybrid On-Board Science Data Processors,” Future In-Space Operations (FISO) Working Group Seminar, 2020, January.
[3] C. Brewer, N. Franconi, R. Ripley, A. Geist, T. Wise, S. Sabogal, G. Crum, S. Heyward, and C. Wilson, “NASA SpaceCube Intelligent Multi-Purpose System for Enabling Remote Sensing, Communication, and Navigation in Mission Architectures,” 34th Annu. AIAA/USU Conf. on Small Satellites, SSC20-VI-07, Logan, UT, Aug. 1-6, 2020.
[4] A. Geist, C. Brewer, M. Davis, N. Franconi, S. Heyward, T. Wise G. Crum, D. Petrick, R. Ripley, C. Wilson, and T. Flatley, “SpaceCube v3.0 NASA Next-Generation High-Performance Processor for Science Applications,” 33rd Annual AIAA/USU Conf. on Small Satellites, SSC19-XII-02, Logan, UT, August 3-8, 2019.

Additional Publications:

[1] MIPI Alliance, “MIPI Specification for D-PHY, Version 1.00.00,” 2009, May.
[2] MIPI Alliance, “MIPI Specification for D-PHY, Version 1.2,” 2014, September 10.
[3] M. Defossez, Xilinx, “D-PHY Solutions. XAPP894 (v1.0.1),” 1, February, 2021.
[4] B. Day, Xilinx, “Compact Camera Port 2 SubLVDS with 7 Series FPGAs High-Range I/O. XAPP582 (v1.0),” 2013, January 31.
[5] e-con Systems, “e-CAM222_CUMI2311_MOD Datasheet,” Guindy, Chennai-600032, 10 February, 2021.

Manufacturer’s Specifications:

[1] ANSI/VITA 57. 1-2008, ANSI/VITA 57 FMC - SIGNALS AND PINOUT (fmchub.github.io) (https://fmchub.github.io/appendix/VITA57_FMC_HPC_LPC_SIGNALS_AND_PINOUT.html)
[2] OSHPARK Specifications, OSH Park Docs ~ Services ~ 2 Layer Prototype Service (https://docs.oshpark.com/services/two-layer/)
[3] IPEX, https://www.i-pex.com/

Software Documentations:

[1] TI-TINA Simulation Tool Documentation, https://www.ti.com/tool/TINA-TI
[2] Texas Instruments, Editors: A. Kay, T. Green, “Analog Engineer’s Pocket Reference,” Addison, TX, 2020.
[3] Altium Designer Documentation, https://www.altium.com/documentation/altium-designer/

# Acronyms

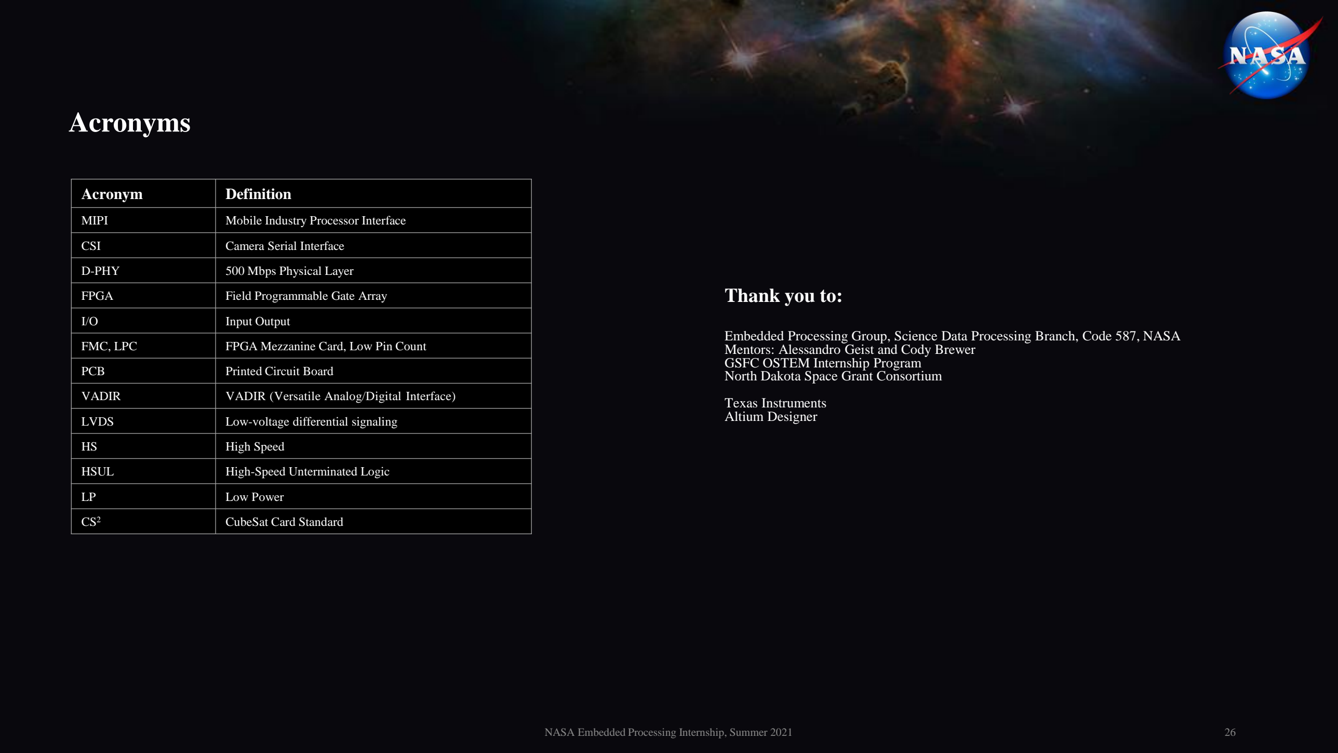
[picture p29: page 26]

Acronym | Definition
MIPI | Mobile Industry Processor Interface
CSI | Camera Serial Interface
D-PHY | 500 Mbps Physical Layer
FPGA | Field Programmable Gate Array
I/O | Input Output
FMC, LPC | FPGA Mezzanine Card, Low Pin Count
PCB | Printed Circuit Board
VADIR | VADIR (Versatile Analog/Digital Interface)
LVDS | Low-voltage differential signaling
HS | High Speed
HSUL | High-Speed Unterminated Logic
LP | Low Power
CS² | CubeSat Card Standard

## Thank you to:

Embedded Processing Group, Science Data Processing Branch, Code 587, NASA Mentors: Alessandro Geist and Cody Brewer
GSFC OSTEM Internship Program
North Dakota Space Grant Consortium

Texas Instruments
Altium Designer

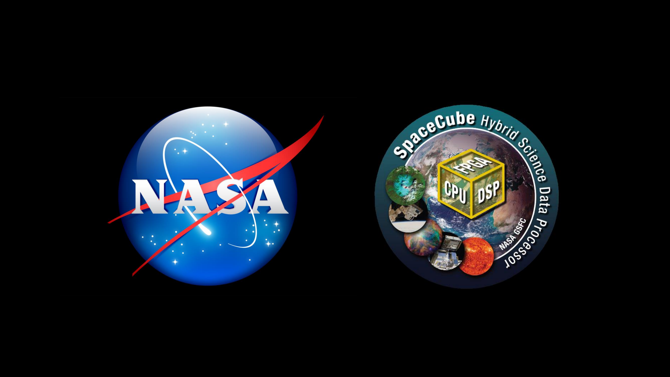
[picture p30: page 27]
