harukakido/NASAProject.FPGACompatibleMIPICameraInterfaceAdapterBoard/Adapter Board Schematic.JPG

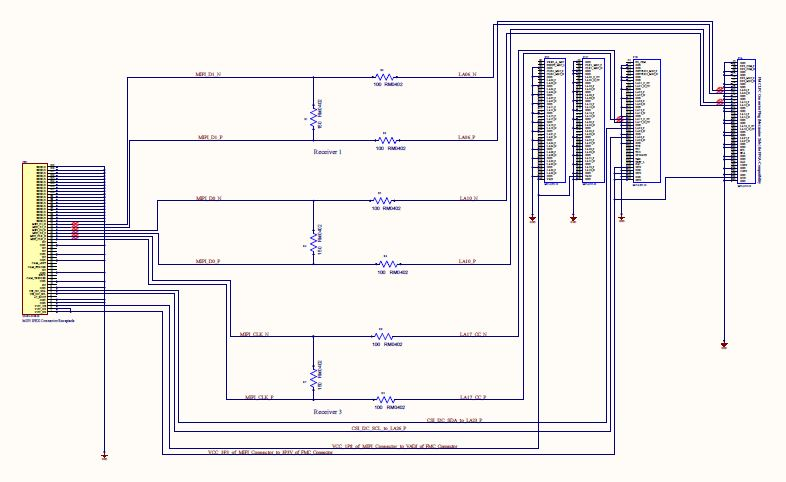
Adapter Board Schematic.JPG
