harukakido/NASAProject.FPGACompatibleMIPICameraInterfaceAdapterBoard/Images of Final Adapter Board/3d xyz.JPG

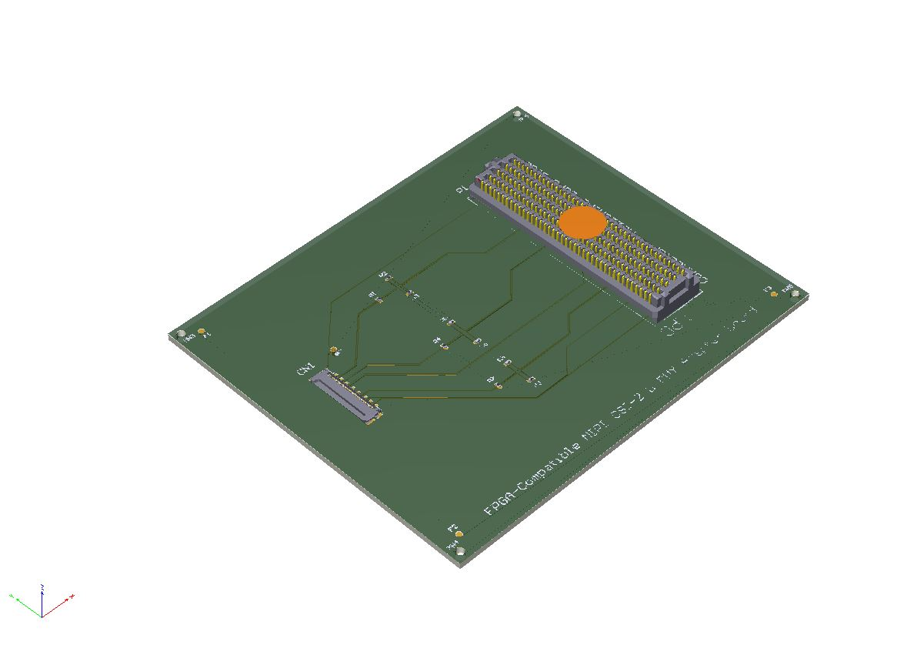
Images of Final Adapter Board/3d xyz.JPG
