harukakido/NASAProject.FPGACompatibleMIPICameraInterfaceAdapterBoard/Images of Final Adapter Board/Final Adapter Board 3D XYZ JPG.JPG

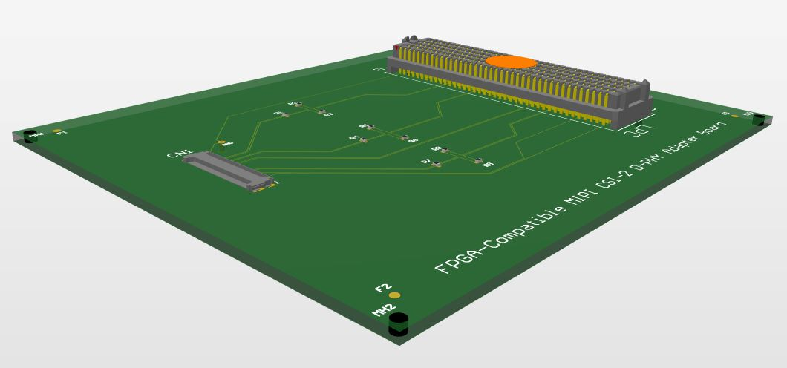
Images of Final Adapter Board/Final Adapter Board 3D XYZ JPG.JPG
