harukakido/NASAProject.FPGACompatibleMIPICameraInterfaceAdapterBoard/Report Outputs/AdapterBoardBOM.xlsx

Description | Designator | LibRef | Value | TOLERANCE | PKG_TYPE | POWER | PROTO_MFG | PROTO_MFG_PN | PROTO_VENDOR | PROTO_VENDOR_PN | Quantity
I-PEX Connector Receptacle. 0.4 mm pitch, Horizontal mating type Micro-coaxial connector with EMI shielding cover and mechanical lock. MIPI-Compatible. | CN1 | 20682-030E-02 |  |  |  |  | I-PEX | 20682-030E-02 | DIGIKEY | 3508-20682-030E-02TR-ND | 1
MC-LPC-10, FMC Low-pin count connector, lead free, 160 I/Os, male, 10 mm mated stack height | P1 | MC-LPC-10_1 |  |  |  |  | SAMTEC | ASP-134604-01 | DIGIKEY | SAM8732-ND | 1
Resistor | R1, R4, R7 | RES_146 | 150 | 2.0% | RM0402 | 0.05 | VISHAY SFERNICE, VISHAY | CH0402-150RGFPA | DIGIKEY | 716-1165-2-ND, [NoParam] | 3
Resistor, 100Ohms, Resistor | R2, R3, R5, R6, R8, R9 | RES_014 | 100 | 1.0% | RM0402 | 0.04 | PANASONIC | ERJ-2RKF1000X | DIGIKEY | P100LCT-ND | 6
