harukakido/NASAProject.FPGACompatibleMIPICameraInterfaceAdapterBoard/Documentation Outputs/Schematic, Draftsman, 3DPDF.PDF

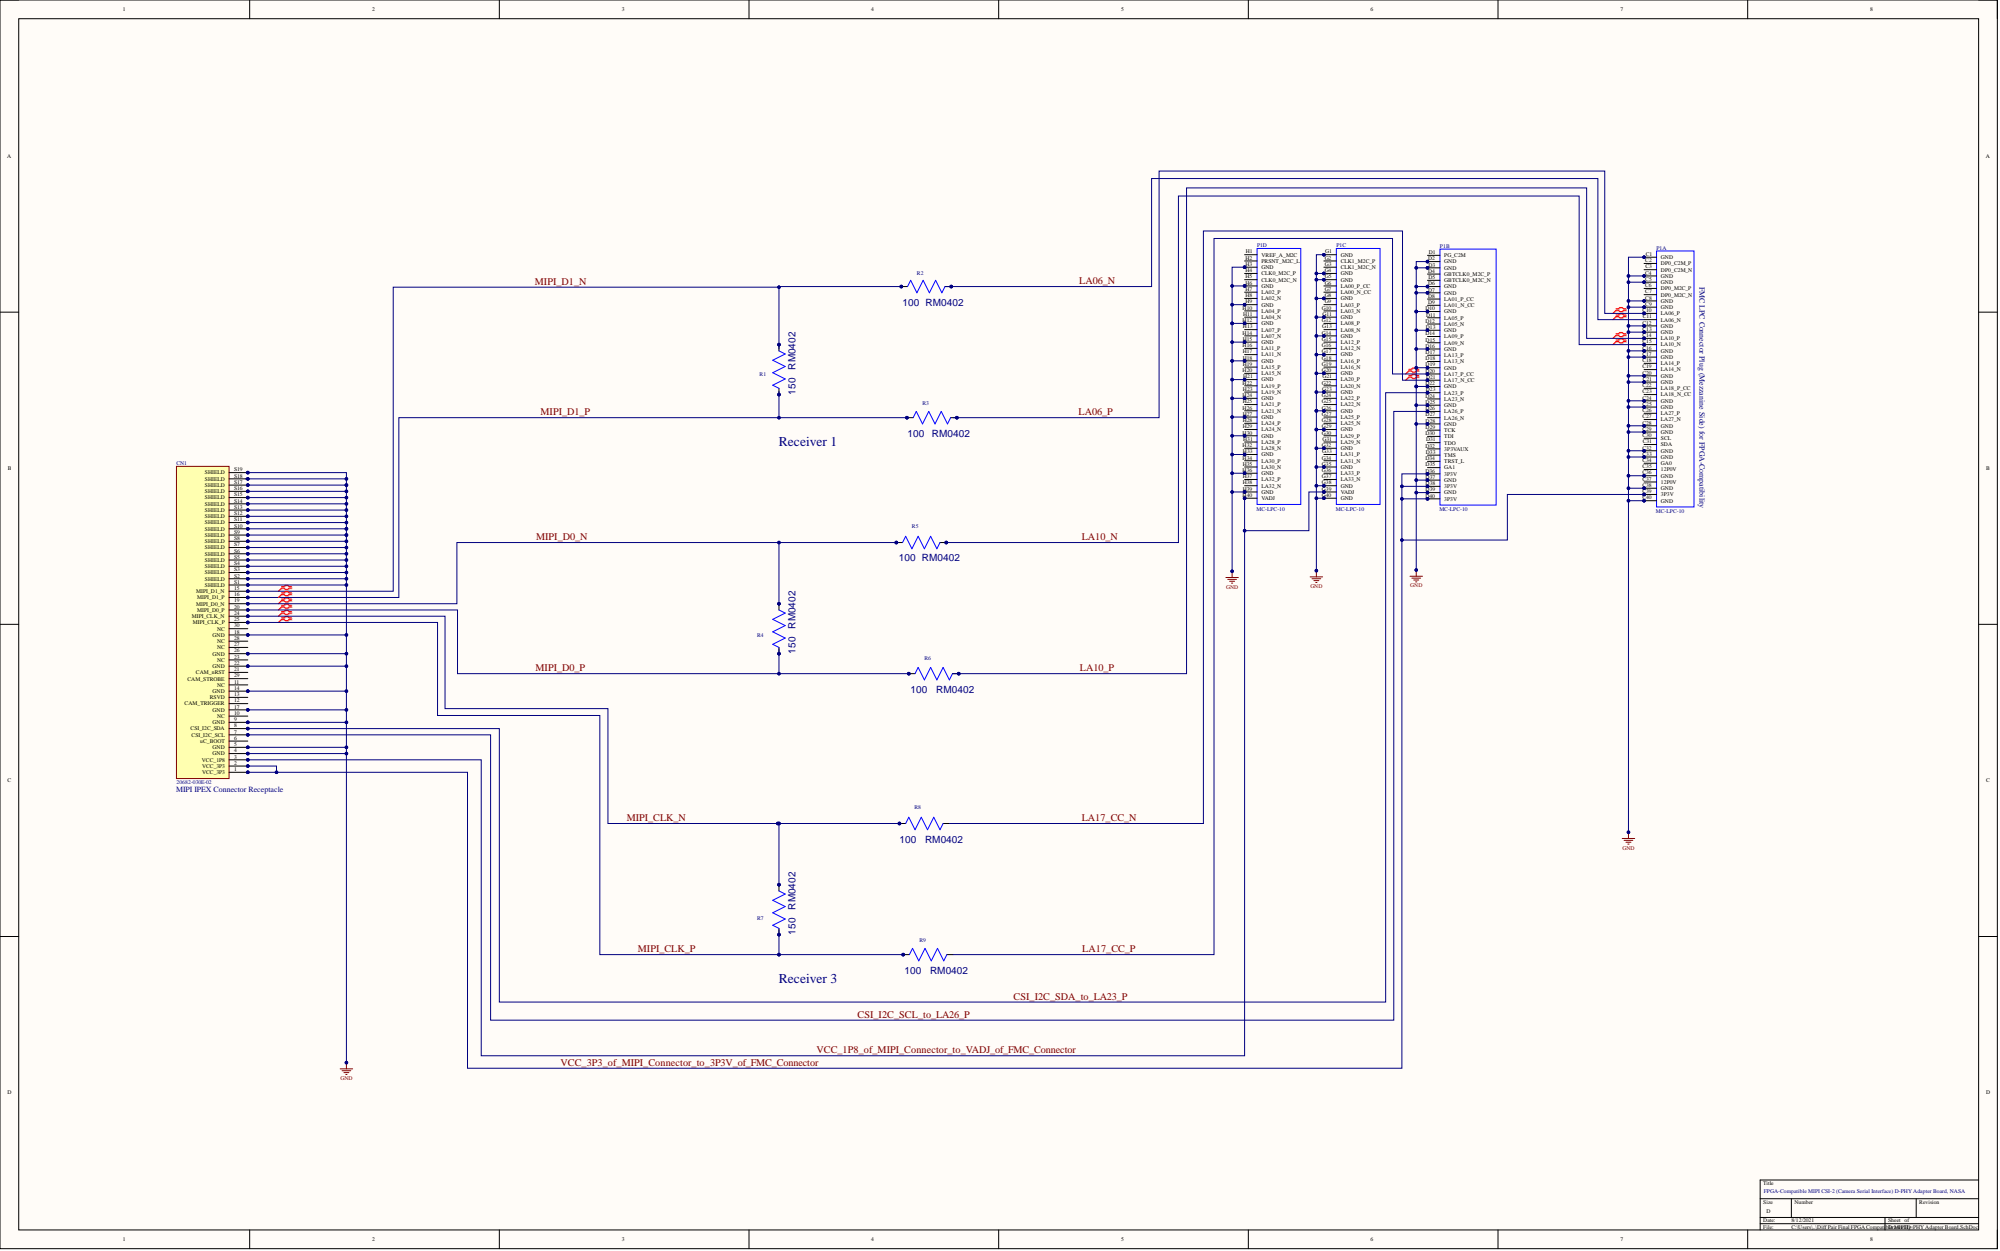
[picture p34: page 1]

FMC LPC Connector Plug (Mezzanine Side) for FPGA-Compatibility

le MIPI CSI-2 (Camera Serial In

bDle rawMIPI n ByD-PH:

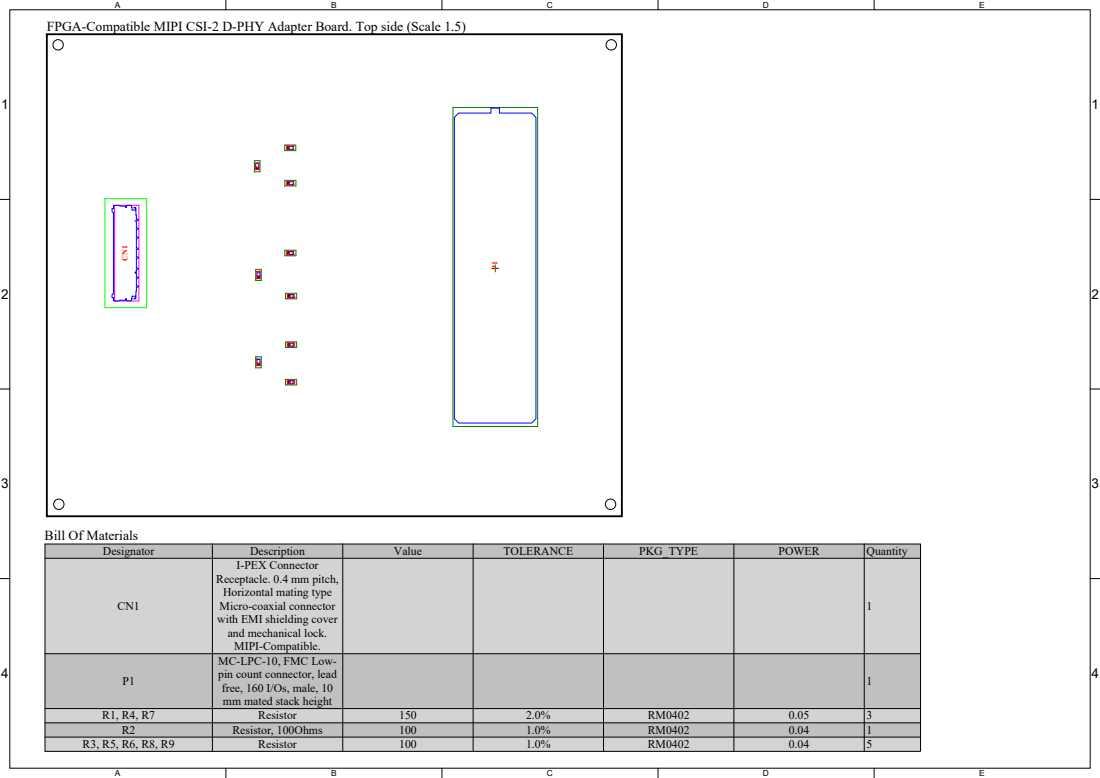
[picture p35: page 3]

FPGA-Compatible MIPI CSI-2 D-PHY Adapter Board. Top side (Scale 1.5)

Designator | Description | Value | TOLERANCE | PKG_TYPE | POWER | Quantity
CN1 | I-PEX Connector Receptacle. 0.4 mm pitch, Horizontal mating type Micro-coaxial connector with EMI shielding cover and mechanical lock. MIPI-Compatible. | | | | | 1

P1 | MC-LPC-10, FMC Low-pin count connector, lead free, 160 I/Os, male, 10 mm mated stack height | | | | | 1

R1, R4, R7 | Resistor | 150 | 2.0% | RM0402 | 0.05 | 3
R2 | Resistor, 100Ohms | 100 | 1.0% | RM0402 | 0.04 | 1

R3, R5, R6, R8, R9 | Resistor | 100 | 1.0% | RM0402 | 0.04 | 5
