harukakido/NASAProject.FPGACompatibleMIPICameraInterfaceAdapterBoard/Diff Pair Final FPGA Compatible MIPI D-PHY Adapter Board PDF.pdf

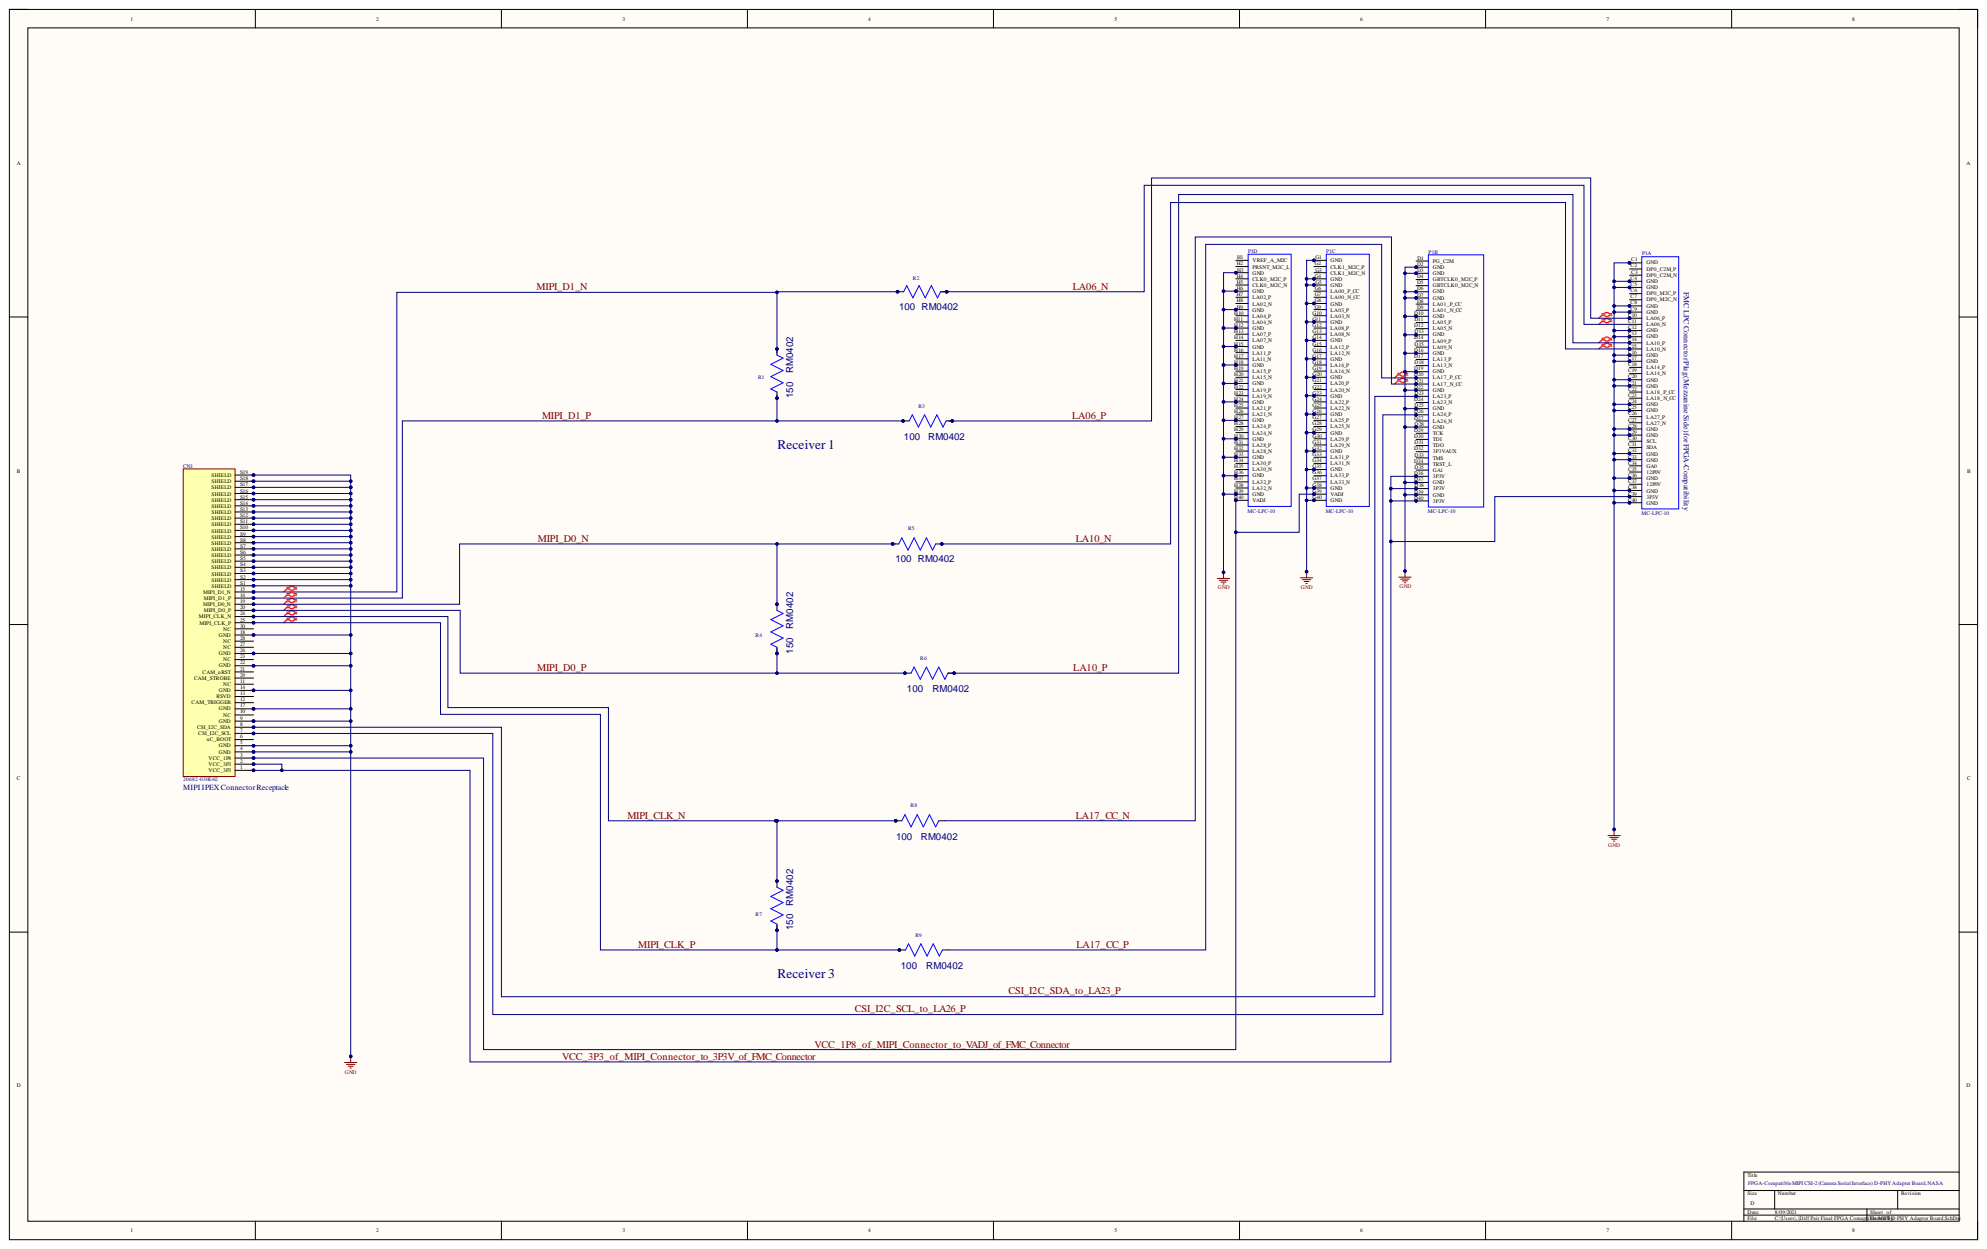
[picture p36: page 1]

FMC LPC ConnectorPlug(Mezzanine Side)forFPGA-Compatibility

Title
FPGA-Compatible MIPI CSI-2(Camera SerialInterface) D-PHY Adapter Board,NASA

Size D | Number | Revision

Date: 8/09/2021 File: C:\Users\..\Diff Pair Final FPGA ComaptibDlrawe MIPI n ByD:-PHY Adapter Board.SchDoc | Sheet of
