harukakido/NASAProject.FPGACompatibleMIPICameraInterfaceAdapterBoard/Assembly Drawing/Assembly Drawing without Designators.PDF

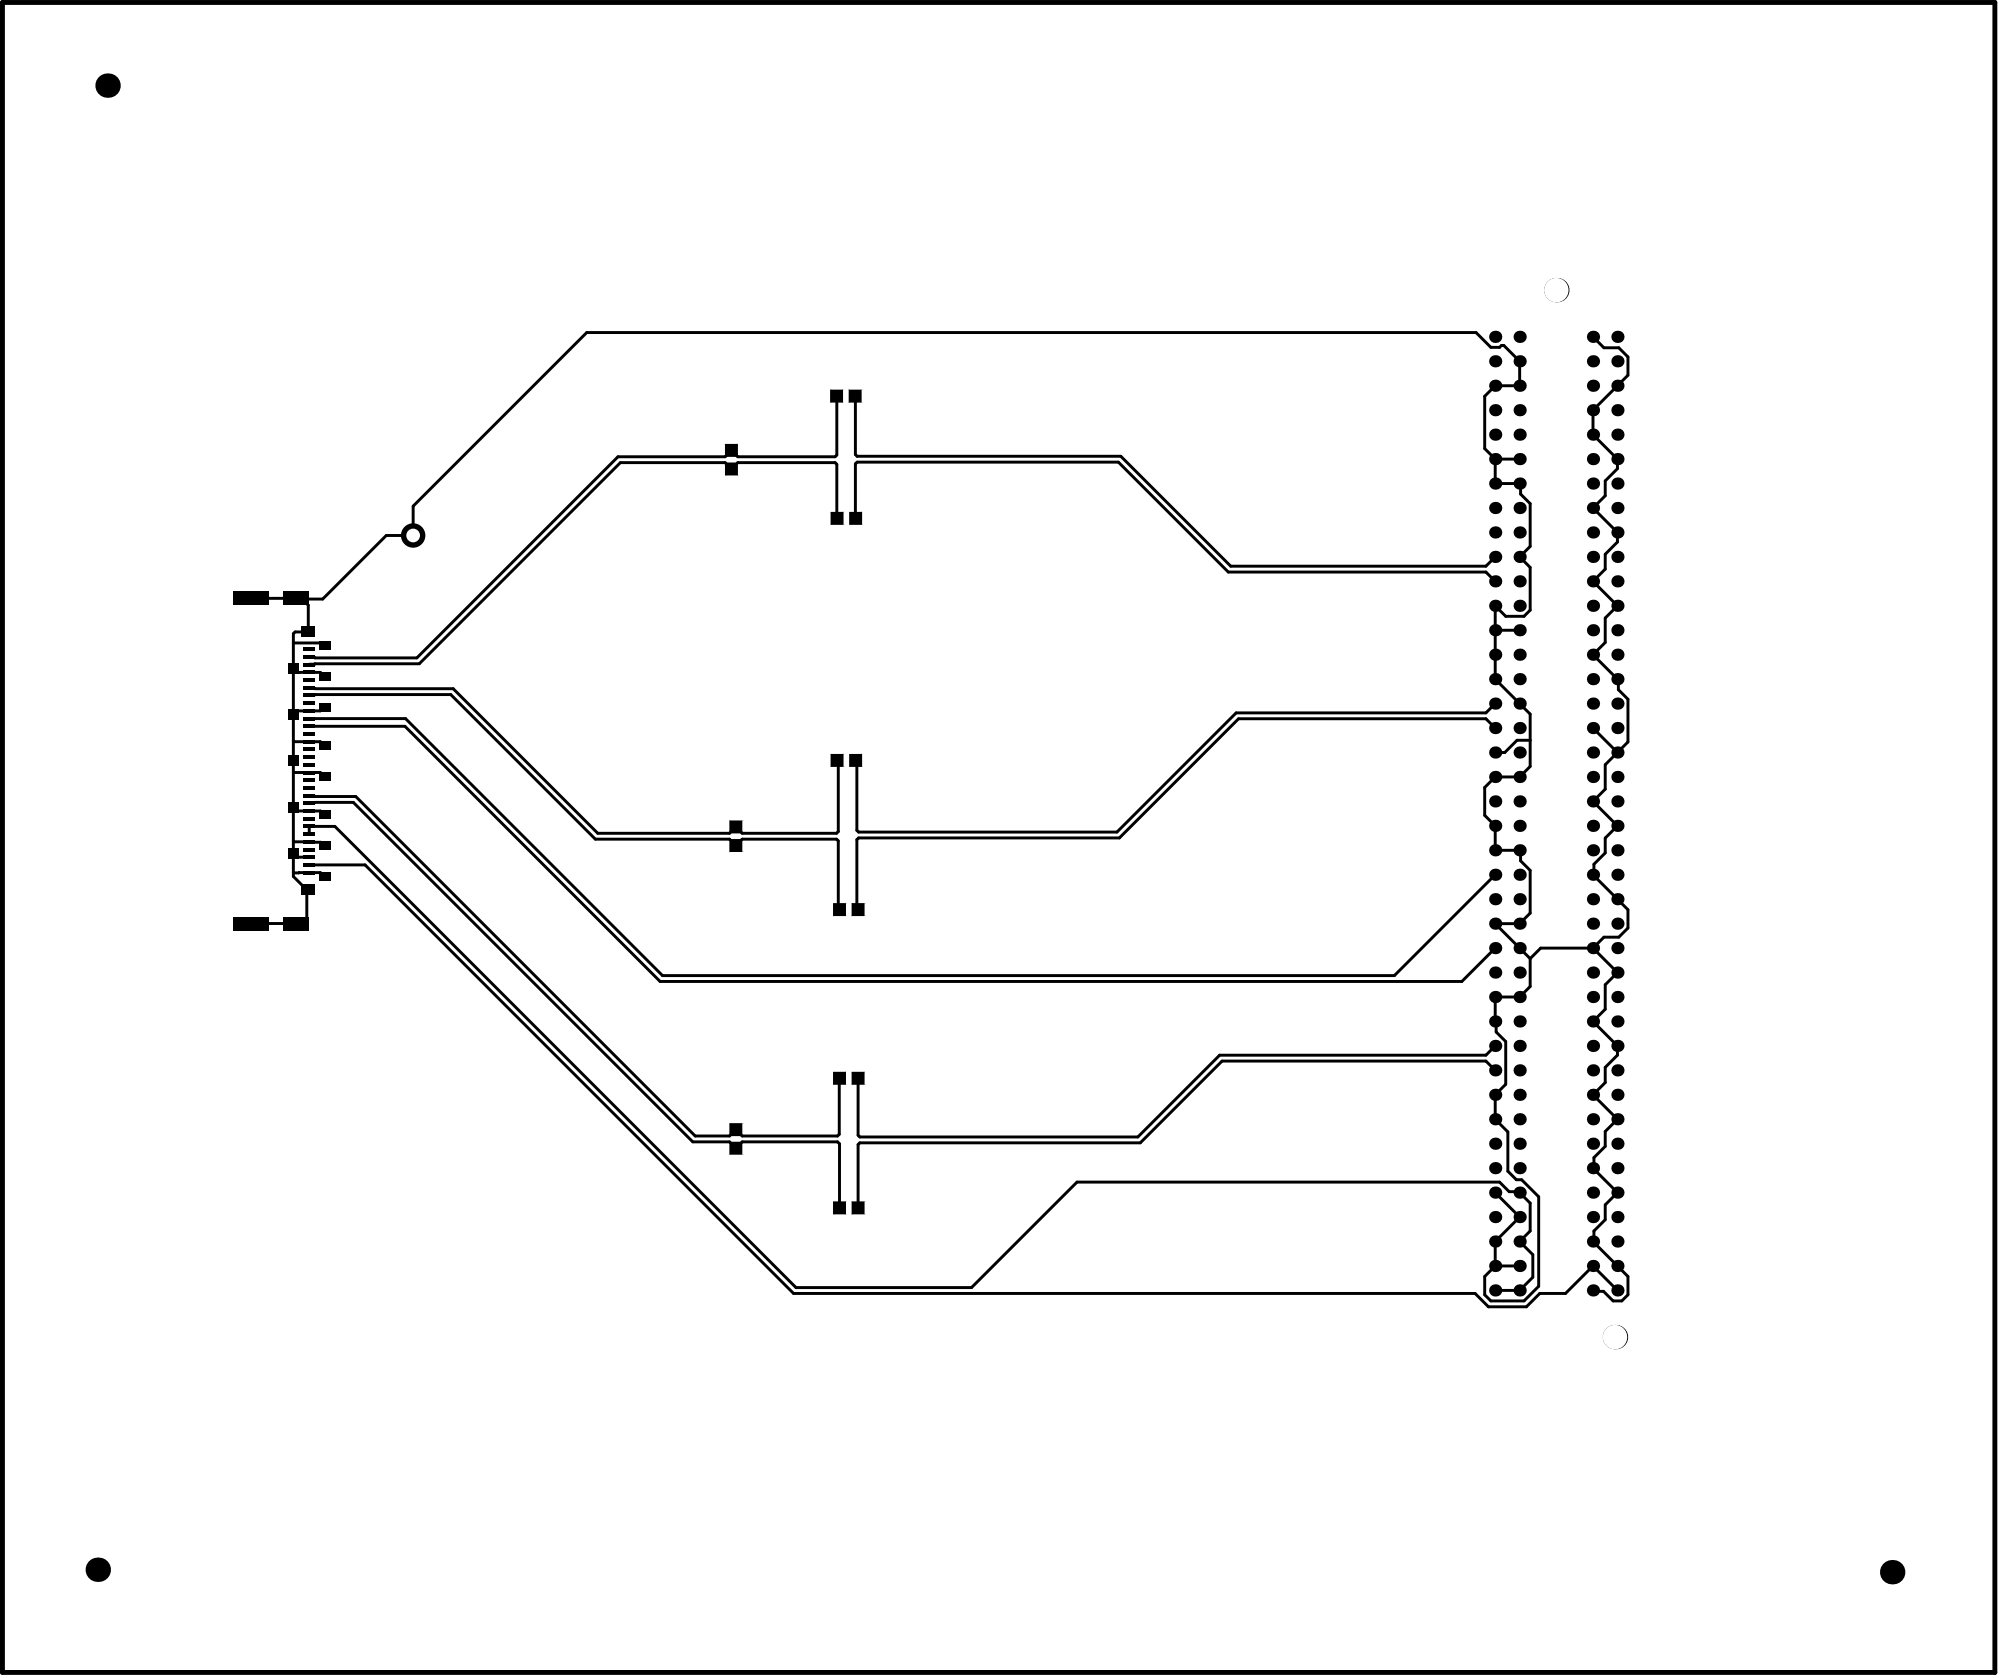
[picture p37: page 1]

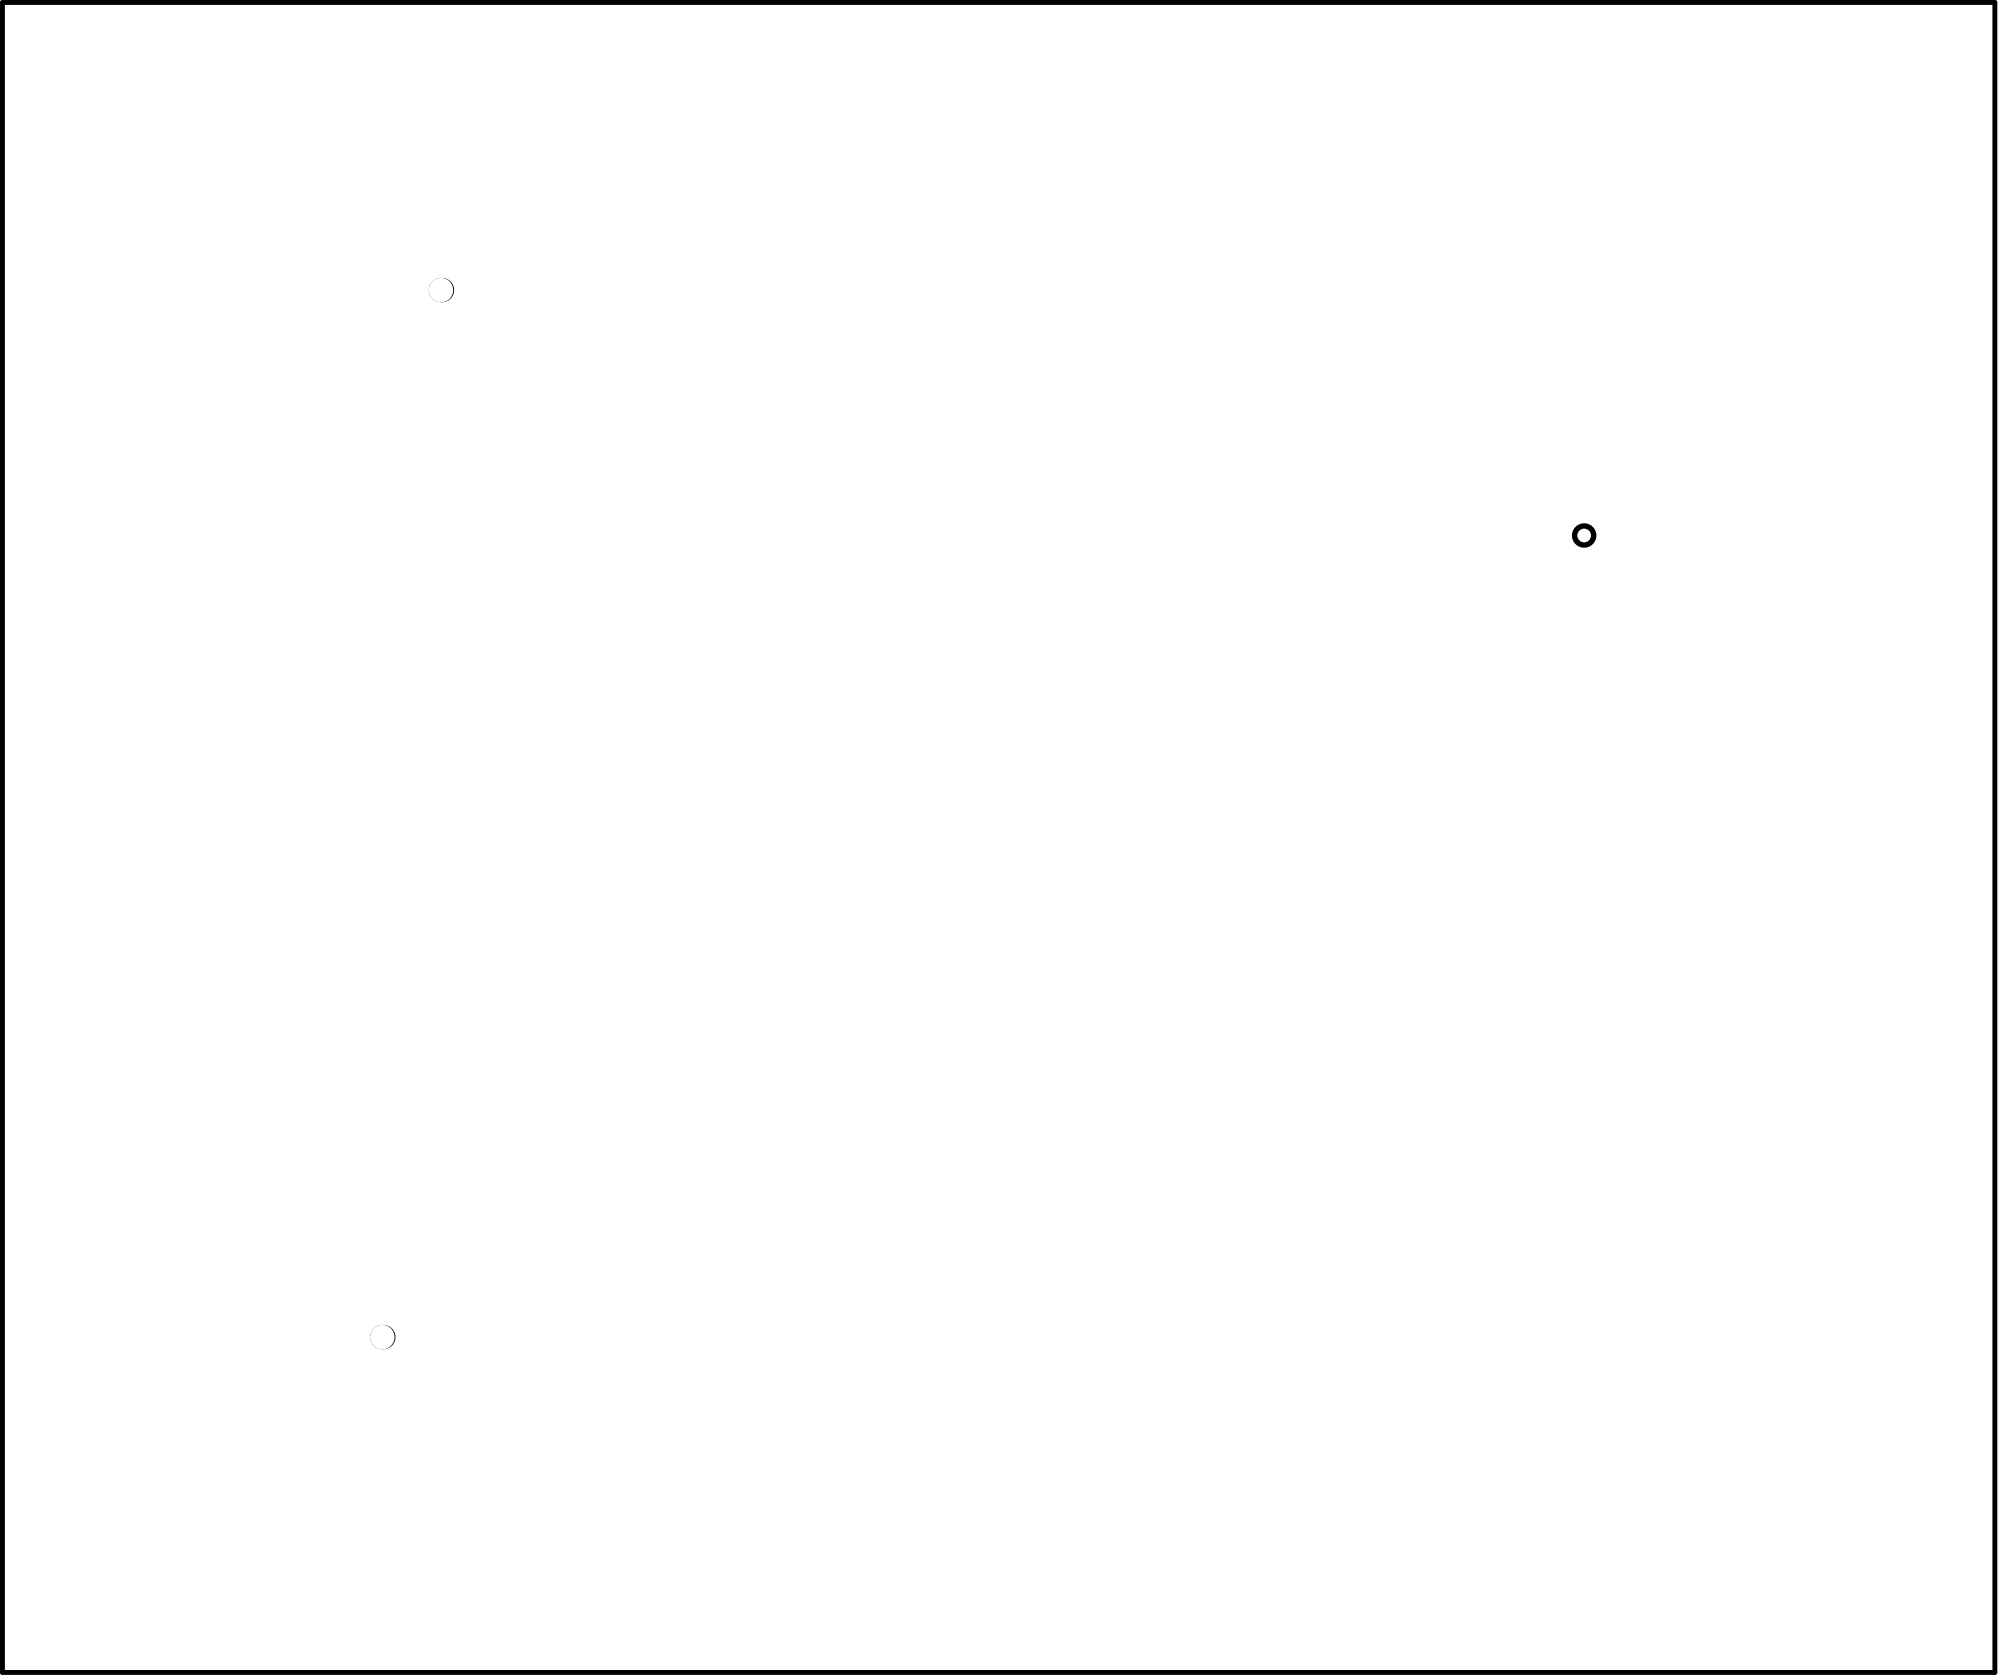
[picture p38: page 2]
