harukakido/NASAProject.FPGACompatibleMIPICameraInterfaceAdapterBoard/Assembly Drawing/Assembly Doc. Final_Adapter_Board_PCB.pdf

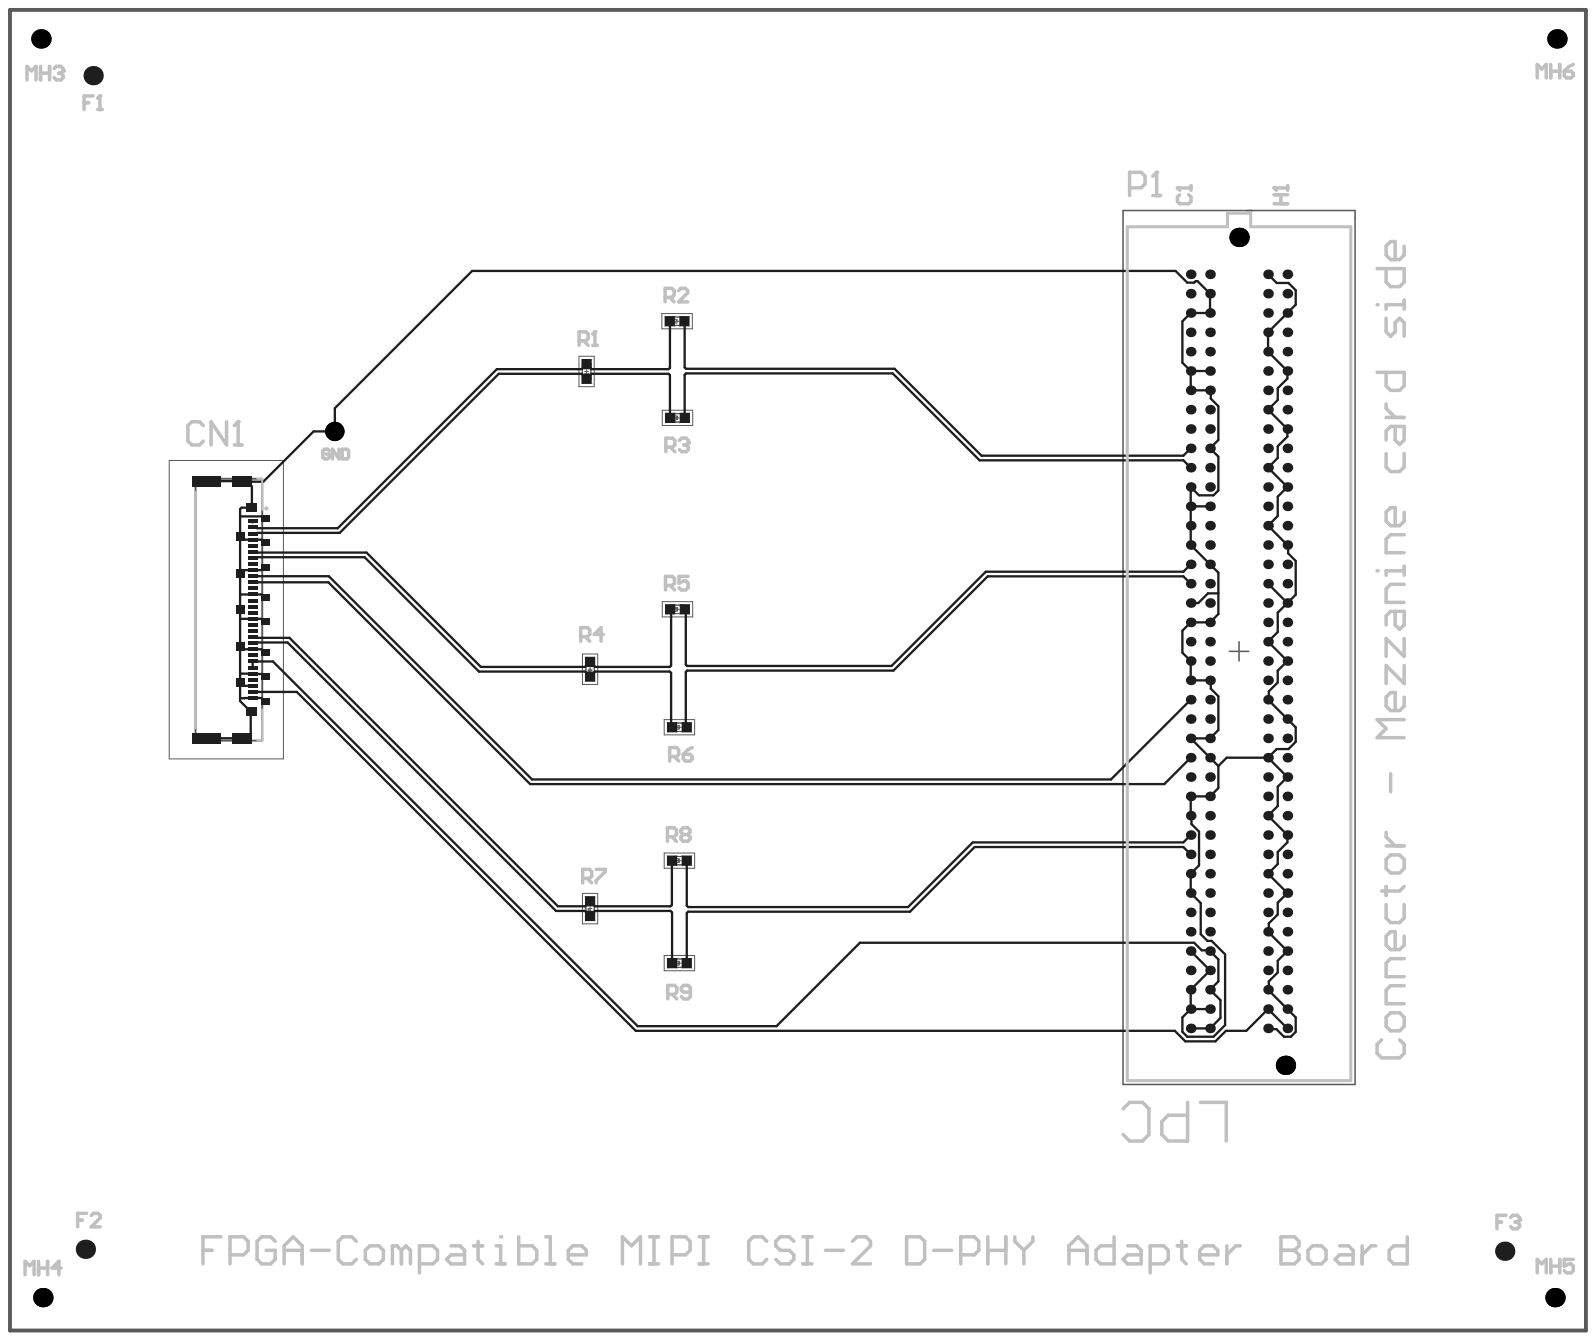
[picture p39: page 1]
