harukakido/NASAProject.FPGACompatibleMIPICameraInterfaceAdapterBoard/(list of files, drawings)

Other design files:
AdapterBoard.PrjPcb
Diff Pair Final FPGA Compatible MIPI D-PHY Adapter Board.SchDoc
